altex111/Quadruped/Docs/Presentations/BME-AUT_slide_template_wide_HU (2).pptx

## AUT diasablon

2020.03.21

Notes: Welcome everyone! I’m Gábor Csorvási from the Budapest University of Technology and Economics, and I’m here to talk about a method to solve the Waiter Motion Problem.

## Dia cím

AUT diasablon

- Fő pont
- Második pont

Notes: Nowadays automation and robotics is one of the most promising branch of engineering. But still has it’s problems.
For example motion planning, where our goal is to determine how to move a robot from A to B configurations.
It may seems an easy task but with many actuators and limitations its still a complex task. Especially if the problem is solved as one huge task.
This is why the most popular approach is to divide the problem into smaller problems which can solve easier.
