altex111/Quadruped/Mechanics/Komáromi Sándor/Quadropod/Quadropod STL/Nyomtatási adatok.xlsx

Név | mennyiség | megjegyzés
BaseBottom_v1 | 1
BaseTop_v1 | 1
LegStart_v1 | 2 | Lehet hogy először fejjel lefelé fogja beszúrni. Az egyik oldalon vannak bemélyített csavarhelyek
LegStart_v1_MIR | 2
LegMiddle_Final_1 | 4
LegEnd_Right_v2 | 2
LegEnd_Right_v2_MIR | 2
LegPin_Corner_v1 | 5
LegPin_Side_v1 | 2
LegPin_Side_v1_MIR | 2
LegPin_v1 | 10
