altex111/Quadruped/Docs/Babits Mátyás/docs/images/quad_side másolata.PNG

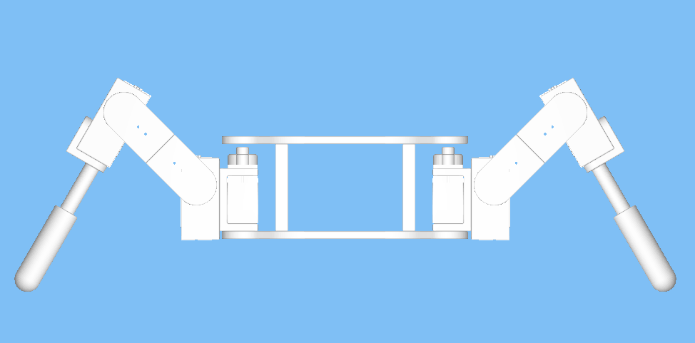
Docs/Babits Mátyás/docs/images/quad_side másolata.PNG
