altex111/Quadruped/Docs/Babits Mátyás/docs/images/quad_top másolata.PNG

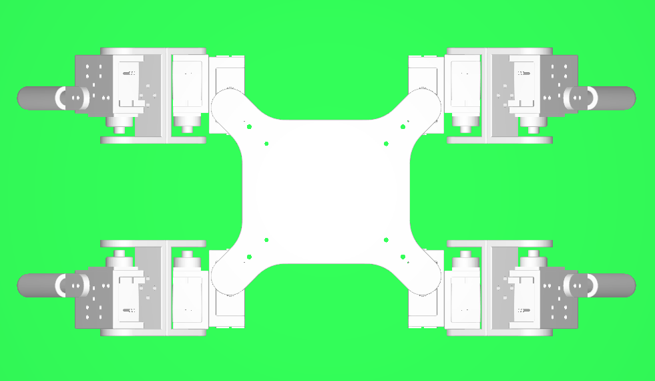
Docs/Babits Mátyás/docs/images/quad_top másolata.PNG
