altex111/Quadruped/Docs/Komaromi Sandor/fotok/Képernyőkép 2021-05-21 165501.png

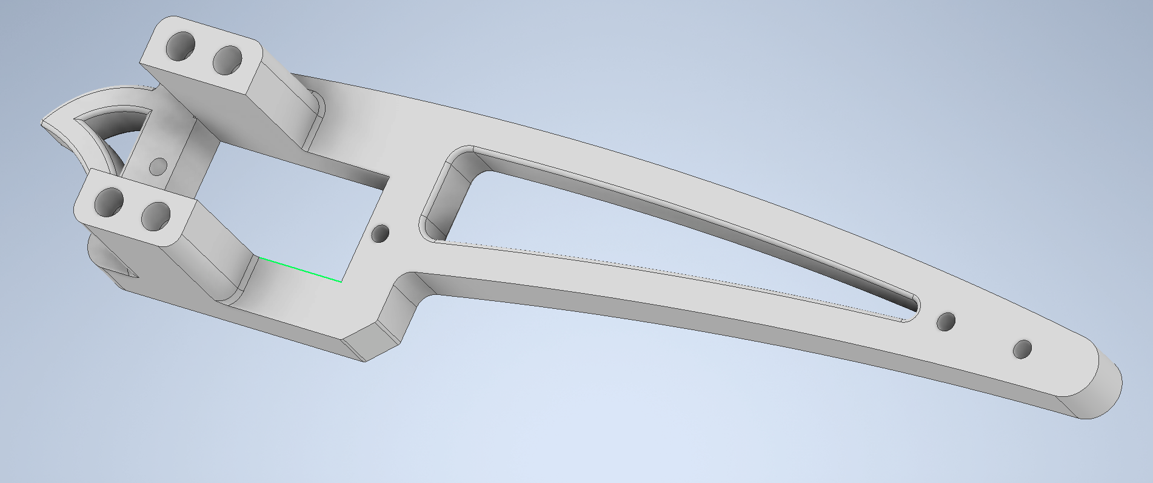
Docs/Komaromi Sandor/fotok/Képernyőkép 2021-05-21 165501.png
