altex111/Quadruped/Docs/Komaromi Sandor/fotok/LIDAR.png

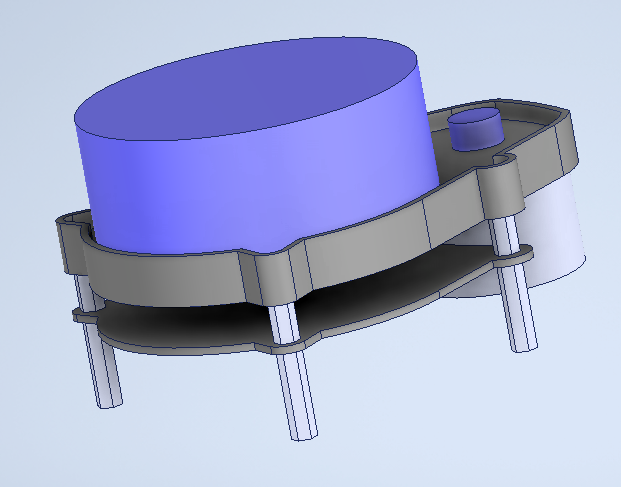
Docs/Komaromi Sandor/fotok/LIDAR.png
