altex111/Quadruped/Docs/Presentations/képek/lab-reszlet-2.png

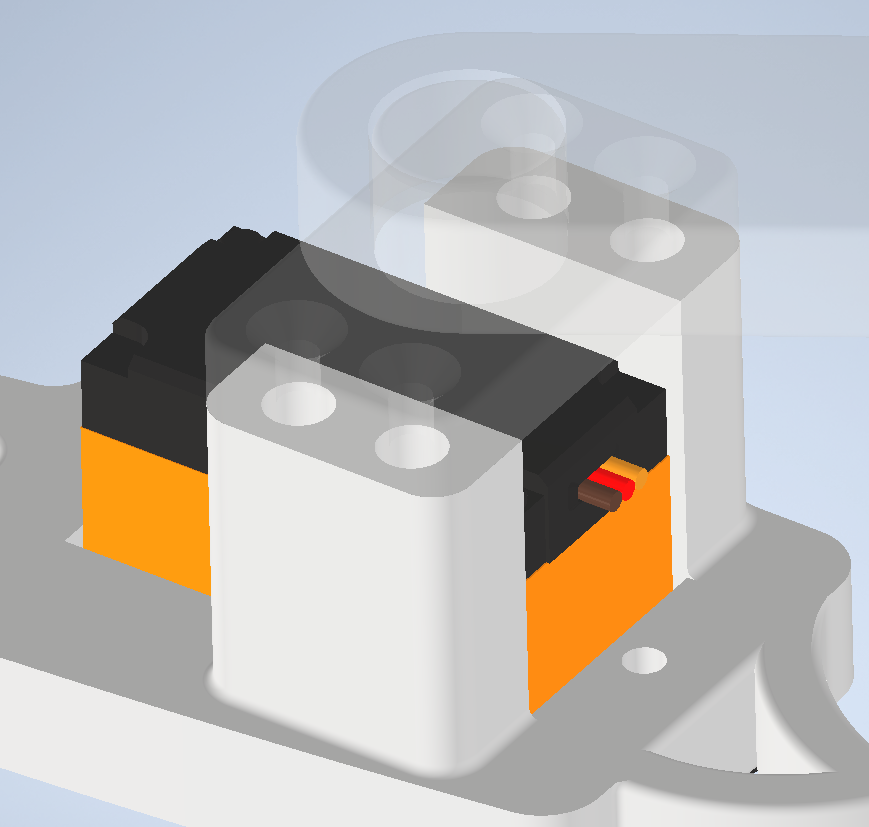
Docs/Presentations/képek/lab-reszlet-2.png
