altex111/Quadruped/Docs/Presentations/képek/mozgas-forgas.jpg

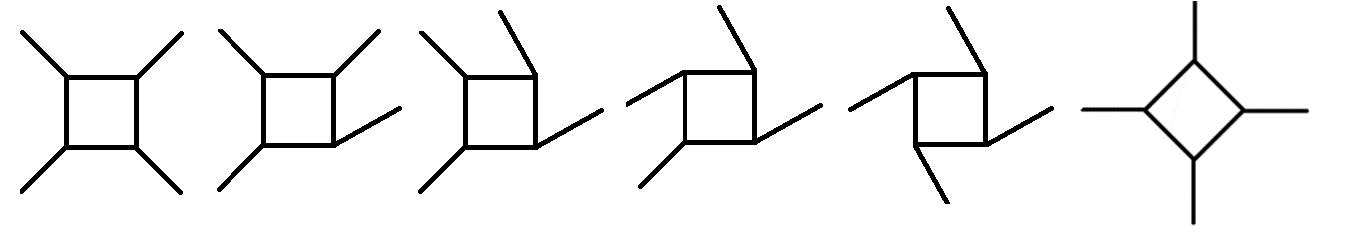
Docs/Presentations/képek/mozgas-forgas.jpg
