altex111/Quadruped/Docs/Presentations/képek/persely-M2.jpg

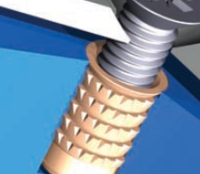
Docs/Presentations/képek/persely-M2.jpg
