altex111/Quadruped/Docs/Presentations/képek/persely-M4.jpg

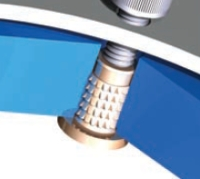
Docs/Presentations/képek/persely-M4.jpg
