altex111/Quadruped/Docs/Presentations/képek/robot-köszön.png

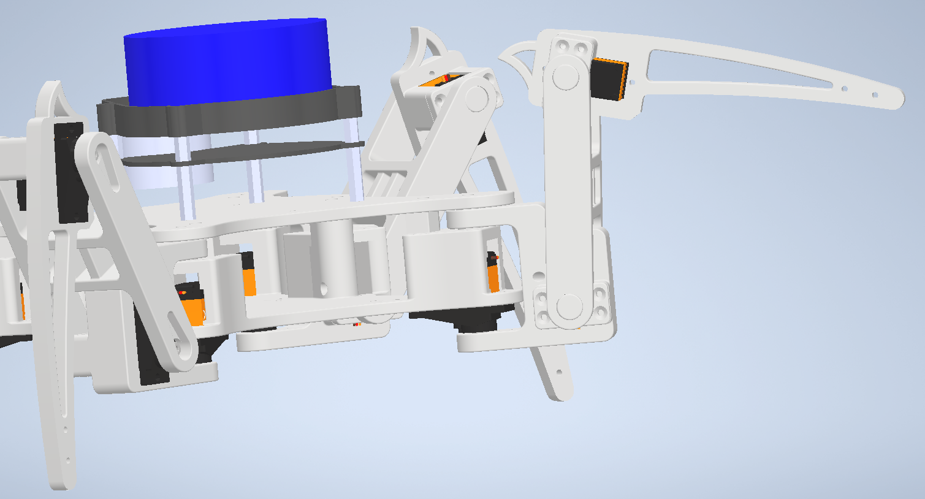
Docs/Presentations/képek/robot-köszön.png
