altex111/Quadruped/Docs/Presentations/képek/szervo-2.jpg

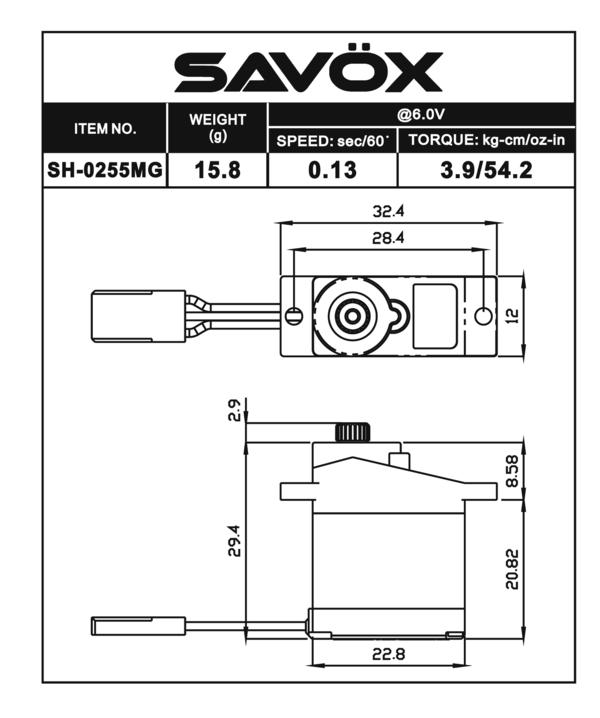
Docs/Presentations/képek/szervo-2.jpg
