altex111/Quadruped/Docs/Presentations/képek/szervo.jpg

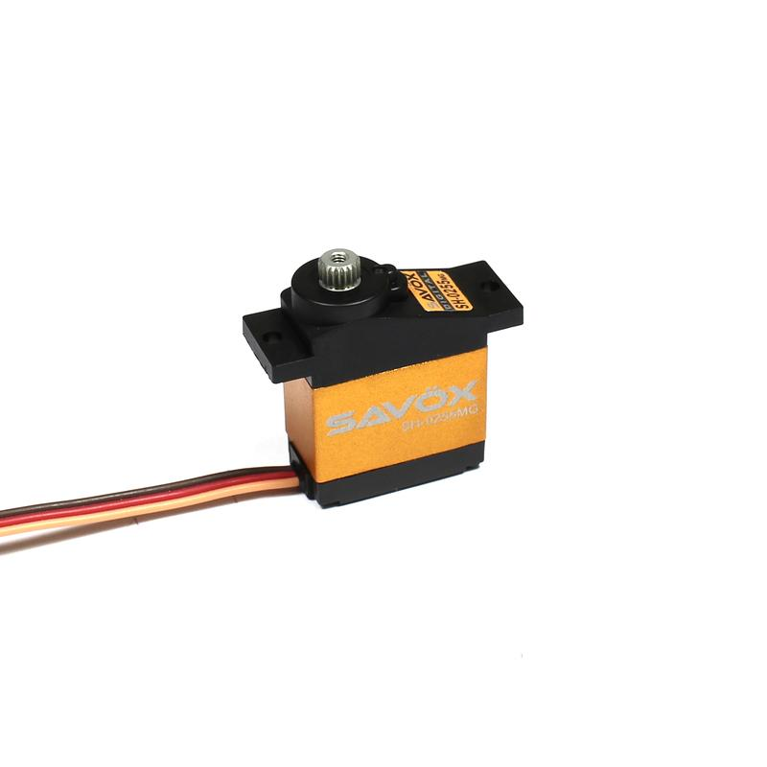
Docs/Presentations/képek/szervo.jpg
