altex111/Quadruped/Docs/Presentations/képek/teszt-pad.png

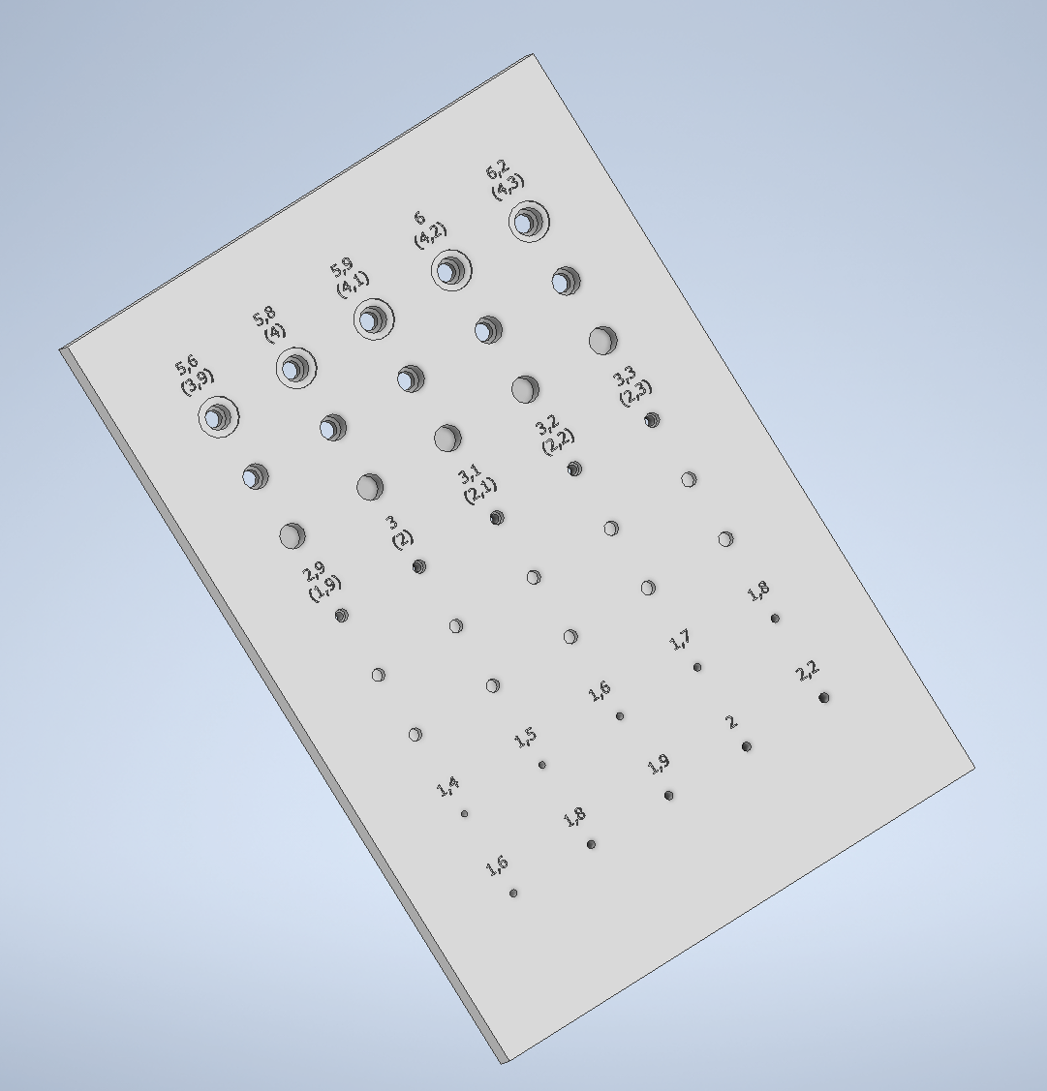
Docs/Presentations/képek/teszt-pad.png
