altex111/Quadruped/Docs/Presentations/képek/zokni.png

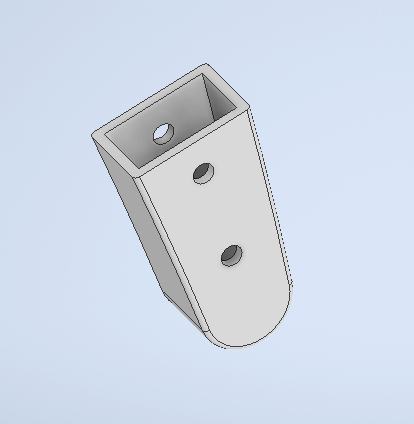
Docs/Presentations/képek/zokni.png
