altex111/Quadruped/Hardware/Massár Lóránt Mátyás/Quadruped_06_18.xlsx

Description | Designator | Reference | Quantity | Supplier | ProjectName | Name
 | S | 1437697 | 1 | Farnell | Quadruped.PrjPcb | Kapcsoló: csúszó; Pozíció:2; SPDT; 2A/250VAC; 5A/28VDC; ON-ON
 | B_RST | 1333652 | 1 | Farnell | Quadruped.PrjPcb | TACT 2.5x 3 2P SPST B3U-1000P (OMR) 2.5x3x1.2mm SMD H=1.2mm 153g
 | U3 | 1593489 | 1 | Farnell |  | Board-To-Board Connector, 2.54 mm, 8 Contacts, Receptacle, 2214S Series, Through Hole, 2 Rows - ESP-01 csatlakozó
 | U1 | 2494459 | 1 | Farnell | Quadruped.PrjPcb | STM32L476RET6 - ARM Microcontroller, Ultra Low Power, STM32 Family STM32L4 Series Microcontrollers, 32bit, 80 MHz
 | U_3V3 | 7208359 | 1 | Farnell | Quadruped.PrjPcb | TS1117BCW-3.3 - Fixed LDO Voltage Regulator, 0V to 12V, 1.3V Dropout, 3.3Vout, 800mAout, SOT-223-3
 | U_5V | 3125120 | 1 | Farnell | Quadruped.PrjPcb | PTH08T231WAD - Non Isolated POL DC/DC Converter, 1 Output, 33 W, 5.5 V, 6 A, Adjustable, Through Hole
Capacitor | C7, C8 | 1762635 | 5 | Farnell | Quadruped.PrjPcb | SMD Multilayer Ceramic Capacitor, 0805
Capacitor | C11 | 2671588 | 2 | Farnell | Quadruped.PrjPcb | GRM32ER60J227ME05L - SMD Multilayer Ceramic Capacitor, 1210 [3225 Metric], 220 µF, 6.3 V, ± 20%, X5R, GRM Series
Polarized Capacitor | C9 | 2762172 | 2 | Farnell | Quadruped.PrjPcb | T491D337M010AT - Surface Mount Tantalum Capacitor, 330 µF, 10 V, T491 Series, ± 20%, 2917 [7343 Metric]
Quarz Crystal | X1 | 2508478 | 1 | Farnell | Quadruped.PrjPcb | QCS8.00000F18B23M - Crystal, 8 MHz, SMD, 12.5mm x 4.6mm, 30 ppm, 18 pF, 20 ppm, QCS Series
Resistor | R1 | 9233938 | 5 | Farnell | Quadruped.PrjPcb | YAGEO (PHYCOMP) RC0805JR-07270RL SMD Chip Resistor, Thick Film, 270 ohm
Resistor | R6 | 2073848 | 5 | Farnell | Quadruped.PrjPcb | MULTICOMP MCMR08X820 JTL SMD Chip Resistor, Ceramic, 82 ohm
Resistor | R9 | 9233881 | 5 | Farnell | Quadruped.PrjPcb | YAGEO (PHYCOMP) RC0805JR-07100RL SMD Chip Resistor, Thick Film, 100 ohm,
Resistor | R10, R11 | 9234004 | 5 | Farnell | Quadruped.PrjPcb | YAGEO (PHYCOMP) RC0805JR-071KL SMD Chip Resistor, Thick Film, 1 kohm
Polarized Capacitor | C10 | 92-01-91 | 5 | Lomex | Quadruped.PrjPcb | 100uF ˝B˝ 10V 20% TAJB107M010RNJ (AVX) 3528
 | P_lb_b, P_lb_k, P_lb_s, P_lf_b, P_lf_k, P_lf_s, P_rb_b, P_rb_k, P_rb_s, P_rf_b, P_rf_k, P_rf_s | 43-16-04 | 12 | Lomex | Quadruped.PrjPcb | TÁPCSATL. 2.00mm 3P APA 180° NCW200-03S (G-S) FORR.
 | P_P | 43-27-99 | 1 | Lomex | Quadruped.PrjPcb | SORKAPOCS 2 P RM3.81 CSAPSORLÉC 90° TLPHC100R-02P (TLM) ZÁRT 10A 150V VDE
4pin Connector | PDB | 43-09-96 | 1 | Lomex | Quadruped.PrjPcb | TÁPCSATL. 2.54mm 4P APA 90° NCW254-04R (G-S) FORR.
Blue LED | D1 | 95-01-58 | 2 | Lomex | Quadruped.PrjPcb | 2012 BLUE 465nm 170mcd FYLS-0805UBC (FYL) W.CLEAR 2.0x1.2x0.8mm 0805 130°
Capacitor | C1, C2 | 82-10-76 | 5 | Lomex | Quadruped.PrjPcb | 100nF 0805 10% 50V X7R 0805B104K500CT (WAL)
Capacitor | C5, C6 | 82-12-79 | 5 | Lomex | Quadruped.PrjPcb | 18pF 0805 5% 50V NP0 CL21C180JBANNNC (SAM)
Fuse | F1 | 44-03-11 | 5 | Lomex | Quadruped.PrjPcb | Lomex
Red LED | D2 | 95-00-19 | 2 | Lomex | Quadruped.PrjPcb | 2012 RED 643nm 28mcd FYLS-0805HRC (FYL) W.CLEAR 2.0x1.2x0.8mm 0805 130°
Resistor | R2, R3, R4 | 80-11-47 | 5 | Lomex | Quadruped.PrjPcb | 20K0 0805 1% CR-05FL7---20K 0.125W (VIK)
Resistor | R5 | 81-34-68 | 5 | Lomex | Quadruped.PrjPcb | 0R00 0805 CR-05JL7----0R 0.125W (VIK) Iav=2A
Resistor | R13 | 80-01-97 | 5 | Lomex | Quadruped.PrjPcb | 160R 0805 1% RC0805FR-07160RL 0.125W (YAG)
Yellow LED | D5 | 95-03-84 | 2 | Lomex | Quadruped.PrjPcb | 2012 YELLOW 590nm 220mcd 0805UYC (FEM) 20mA W.CLEAR 2.0x1.2x0.68mm 0805 140°
 | 4pin Connector for BNO055 | 43-30-32 | 1 | Lomex |  | HÜVELY 4 P FHSH-2.54-04 (T-T) 1# h=8,5mm AU
 | 6pin Connector for BNO055 | 43-28-13 | 1 | Lomex |  | HÜVELY 6 P FHSH-2.54-06 (T-T) 1# h=8,5mm AU
 | PDB | 43-09-08 | 1 | Lomex |  | TÁPCSATL. 2.54mm 4P ANYA HÁZ NCH254-04 (G-S)
 | 2.54mm crimp | 43-26-57 | 50 | Lomex |  | TÁPCSATL. 2.54mm ANYA CRIMP. DNCT254-T22F (G-S) AWG22-28 TIN ÓNOZOTT
 | P_lb | 43-15-99 | 3 | Lomex |  | TÁPCSATL. 2.00mm 3P ANYA HÁZ NCH200-03 (G-S)
 | YDLIDAR X2 csatlakozó | 43-15-91 | 0 | Lomex |  | TÁPCSATL. 1.25mm 4P APA 180° MNCW125-04S (G-S) FORR.
 | YDLIDAR X2 csatlakozó (1.25mm) crimp | 43-15-97 | 0 | Lomex |  | TÁPCSATL. 1.25mm ANYA CRIMP. AWG28-32 MNCT125-T28 (G-S) ÓNOZOTT
 | 2.00 mm crimp | 43-00-25 | 20 | Lomex |  | TÁPCSATL. 2.00mm ANYA CRIMP. NCT200S-T2430 (G-S) AWG24-30
4pin Connector | PLIDAR | 43-17-55 | 1 | Lomex | Quadruped.PrjPcb | TÁPCSATL. 2.00mm 4P APA 90° B4B-PH-SM4-TB (LF)(SN) (JST) SMD Ł
 | Adafruit BNO055 | 485-2472 | 1 | Mouser Electronics | Quadruped.PrjPcb | Adafruit BNO055
 | YDLIDAR X2 | RB-Ydl-04 | 1 | Robotshop |  | YDLIDAR X2 360° Laser Scanner
