altex111/Quadruped/Mechanics/Babits Mátyás/servo.stl

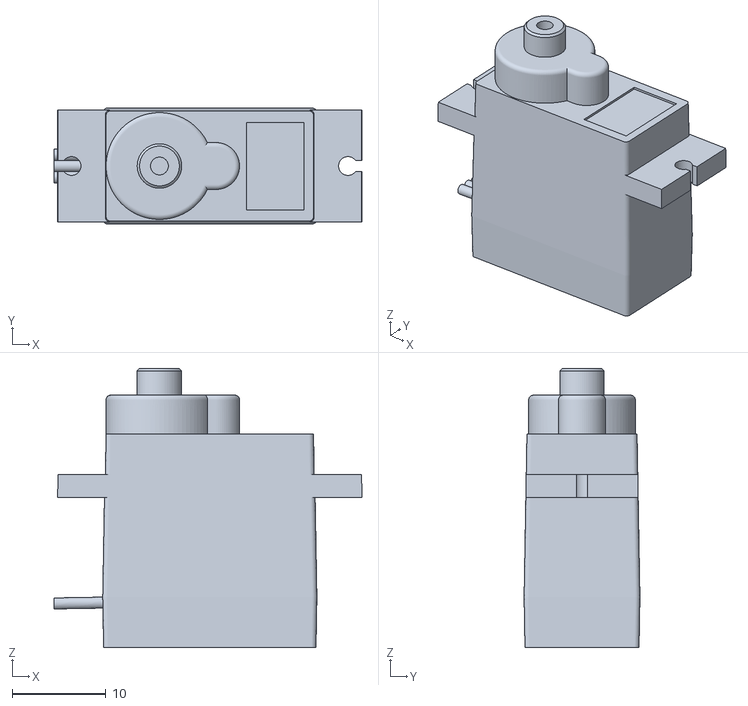
[picture p92: CAD file, 2022-03-31]
Mechanics/Babits Mátyás/servo.stl
32.9 x 12.4 x 29.8
