altex111/Quadruped/Mechanics/Komáromi Sándor/Quadropod/Quadropod MDL/SimulationModell_STL/LegEnd.stl

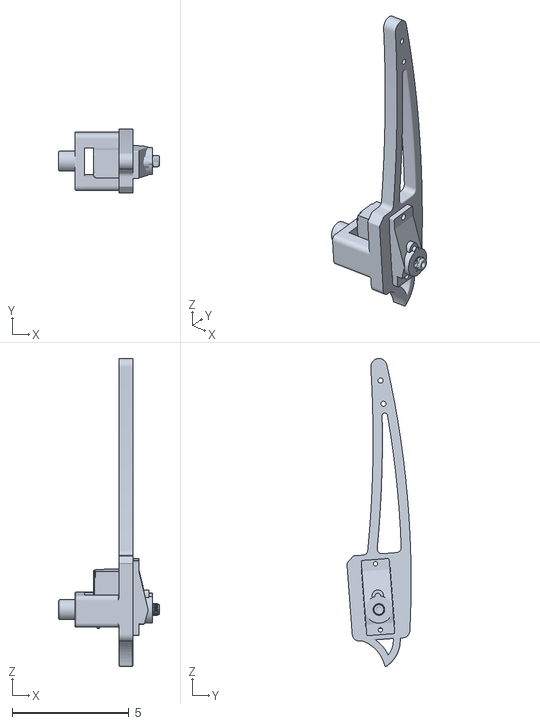
[picture p93: CAD file, 2022-04-13]
Mechanics/Komáromi Sándor/Quadropod/Quadropod MDL/SimulationModell_STL/LegEnd.stl
4.32 x 2.75 x 13.2
