altex111/Quadruped/Mechanics/Komáromi Sándor/Quadropod/Quadropod STL/BaseTop_v1.stl

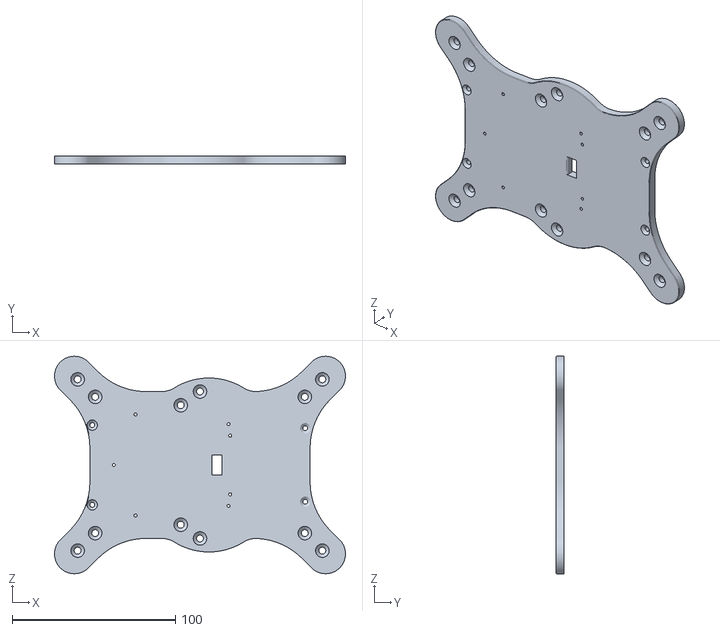
[picture p94: CAD file, 2022-03-31]
Mechanics/Komáromi Sándor/Quadropod/Quadropod STL/BaseTop_v1.stl
178.3 x 5.00 x 133.3
