altex111/Quadruped/Quadruped/Mechanics/Komáromi Sándor/Quadropod/Quadropod MDL/SimulationModell_STL/LegMiddle.stl

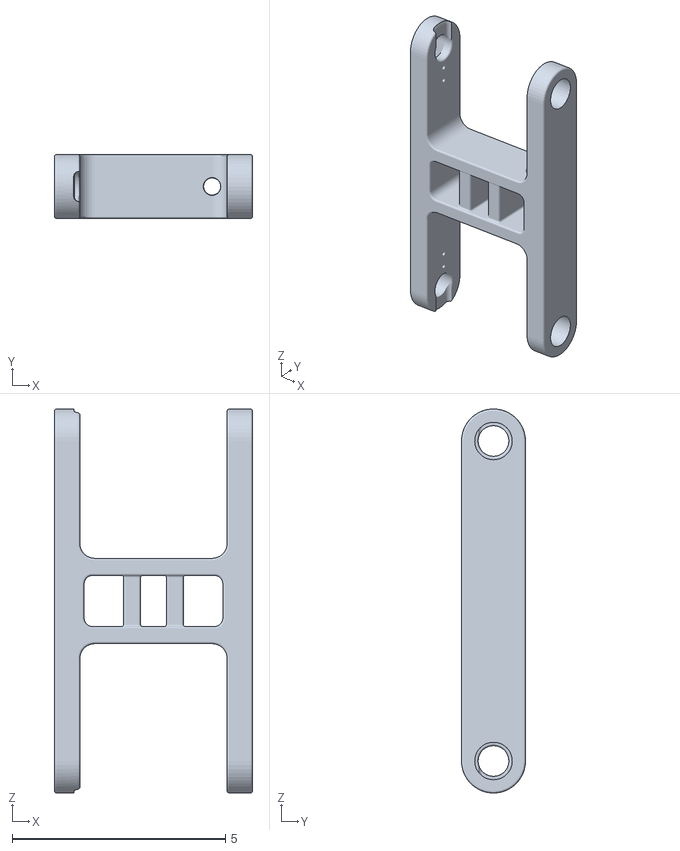
[picture p95: CAD file, 2022-04-03]
Quadruped/Mechanics/Komáromi Sándor/Quadropod/Quadropod MDL/SimulationModell_STL/LegMiddle.stl
4.65 x 1.50 x 9.00
