altex111/Quadruped/Quadruped/Mechanics/Komáromi Sándor/Quadropod/Quadropod STL/LegMiddle_Final_1.stl

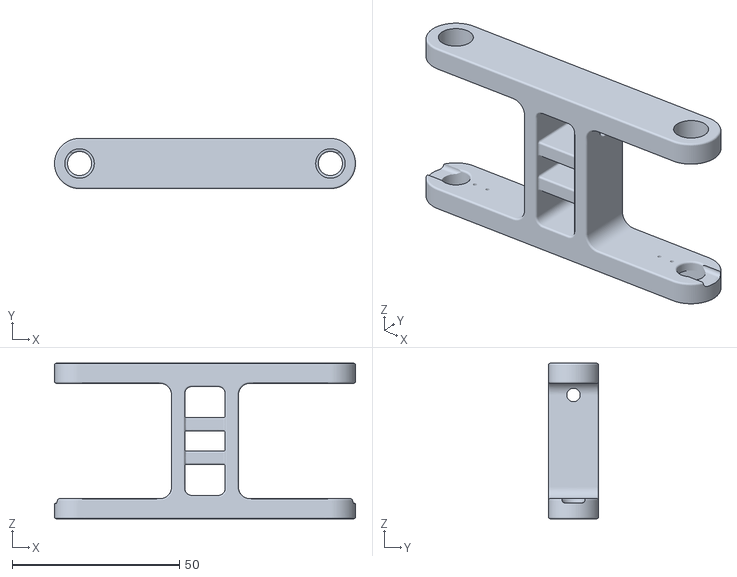
[picture p96: CAD file, 2022-03-31]
Quadruped/Mechanics/Komáromi Sándor/Quadropod/Quadropod STL/LegMiddle_Final_1.stl
90.0 x 15.0 x 46.5
