altex111/Quadruped/Mechanics/Babits Mátyás/support.stl

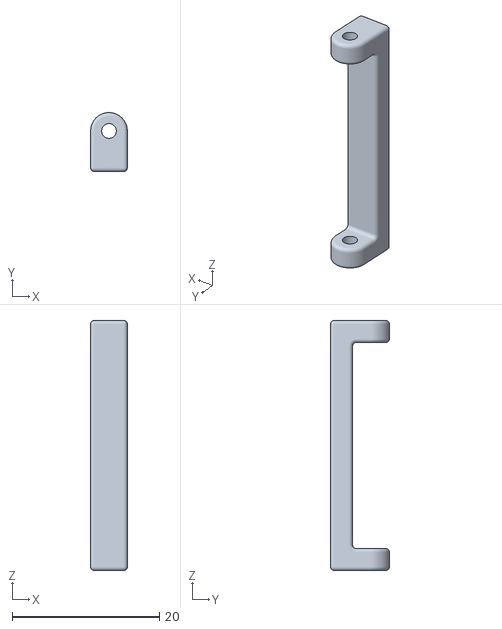
[picture p97: CAD file, 2022-03-31]
Mechanics/Babits Mátyás/support.stl
5.00 x 8.00 x 34.0
