altex111/Quadruped/Mechanics/Komáromi Sándor/Quadropod/Quadropod STL/LegPin_Side_v1.stl

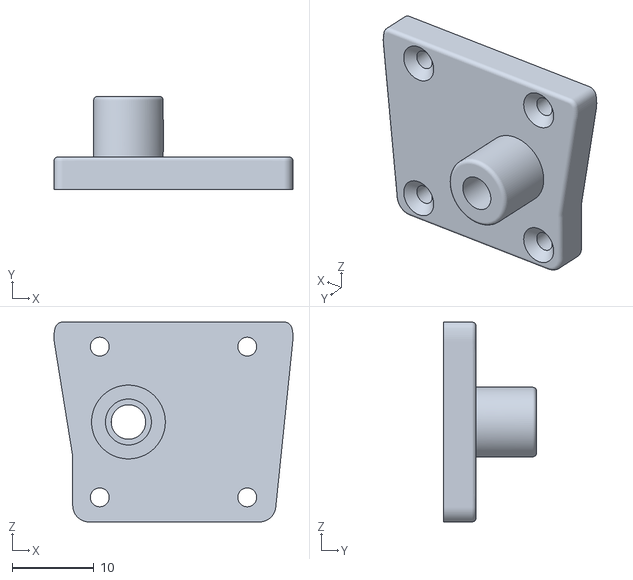
[picture p98: CAD file, 2022-03-31]
Mechanics/Komáromi Sándor/Quadropod/Quadropod STL/LegPin_Side_v1.stl
29.2 x 11.4 x 24.4
