altex111/Quadruped/Quadruped/Mechanics/Komáromi Sándor/Quadropod/Quadropod STL/LegStart_v1.stl

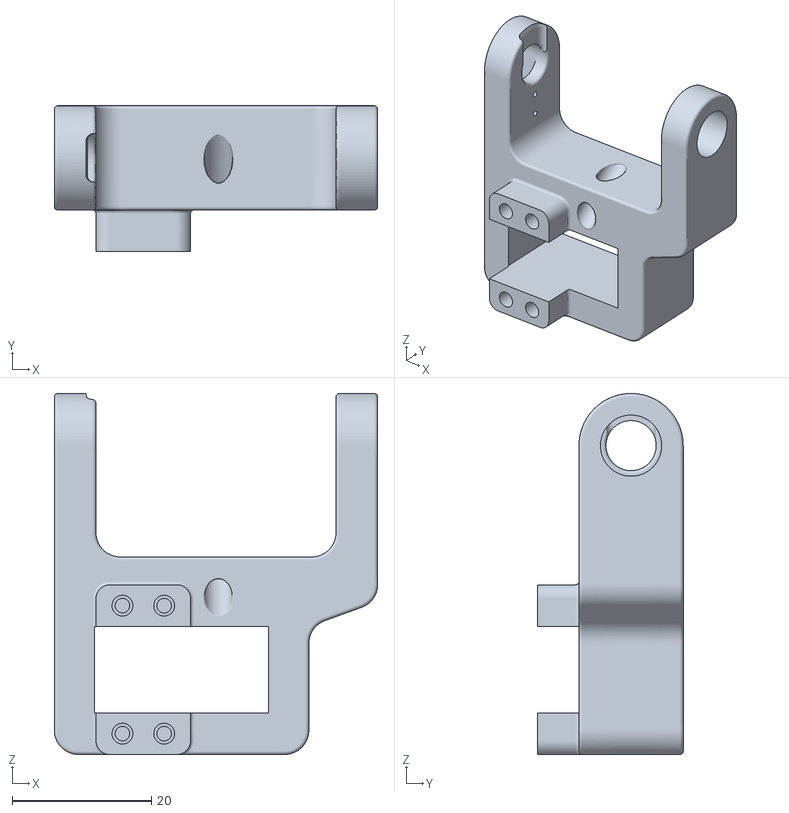
[picture p99: CAD file, 2022-03-31]
Quadruped/Mechanics/Komáromi Sándor/Quadropod/Quadropod STL/LegStart_v1.stl
46.5 x 20.9 x 51.9
