altex111/Quadruped/Mechanics/Babits Mátyás/end.stl

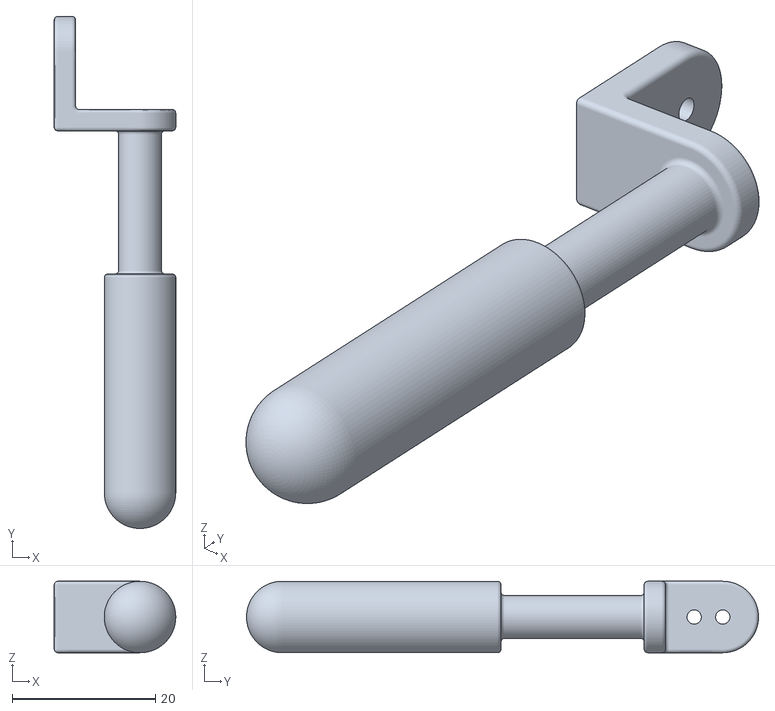
[picture p100: CAD file, 2022-03-31]
Mechanics/Babits Mátyás/end.stl
17.0 x 71.6 x 10.0
