altex111/Quadruped/Mechanics/Komáromi Sándor/Quadropod/Quadropod MDL/SimulationModell_STL/LegStart_MIR.stl

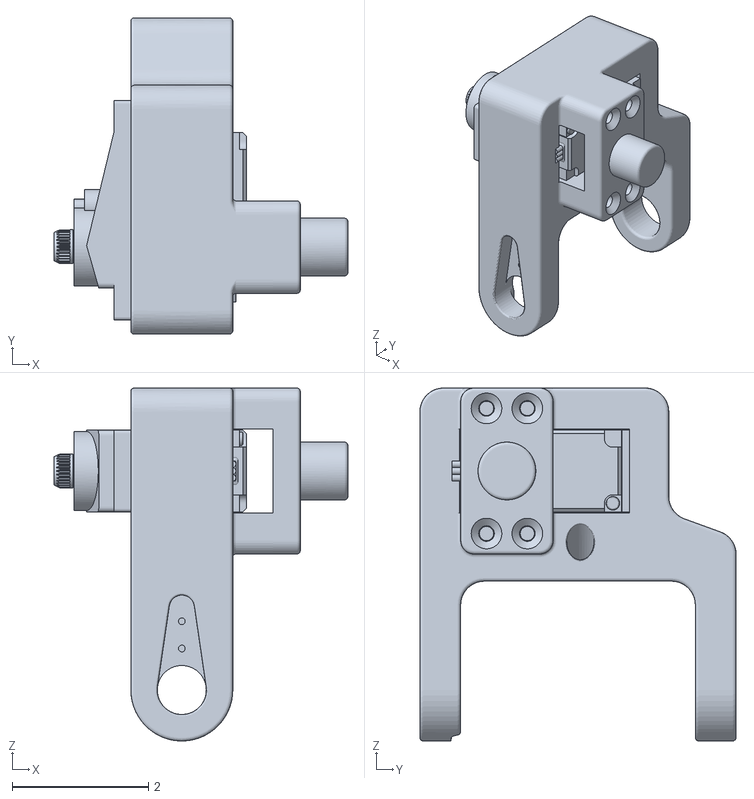
[picture p101: CAD file, 2022-04-13]
Mechanics/Komáromi Sándor/Quadropod/Quadropod MDL/SimulationModell_STL/LegStart_MIR.stl
4.32 x 4.65 x 5.19
