altex111/Quadruped/Mechanics/Babits Mátyás/holder.stl

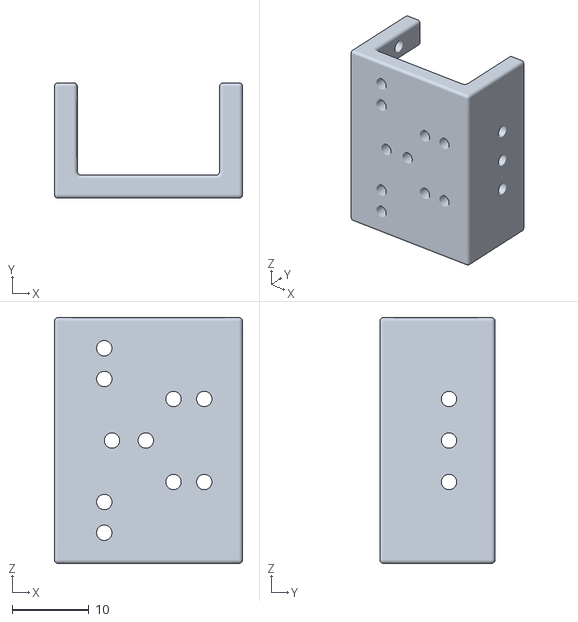
[picture p102: CAD file, 2022-03-31]
Mechanics/Babits Mátyás/holder.stl
24.5 x 15.0 x 32.0
