altex111/Quadruped/Quadruped/Mechanics/Babits Mátyás/body.stl

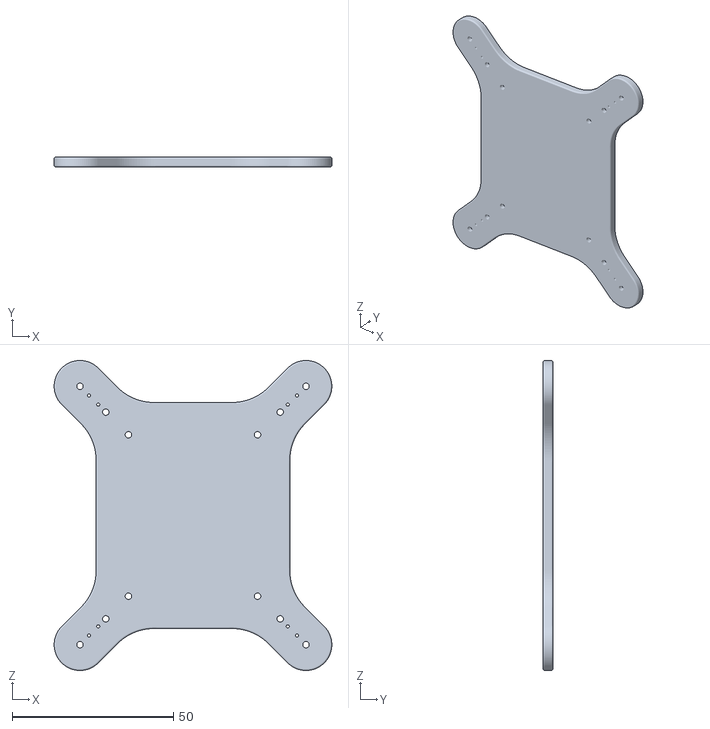
[picture p103: CAD file, 2022-03-31]
Quadruped/Mechanics/Babits Mátyás/body.stl
86.0 x 3.00 x 96.0
