altex111/Quadruped/Mechanics/Komáromi Sándor/Quadropod/Quadropod STL/LegEnd_Right_v2_MIR.stl

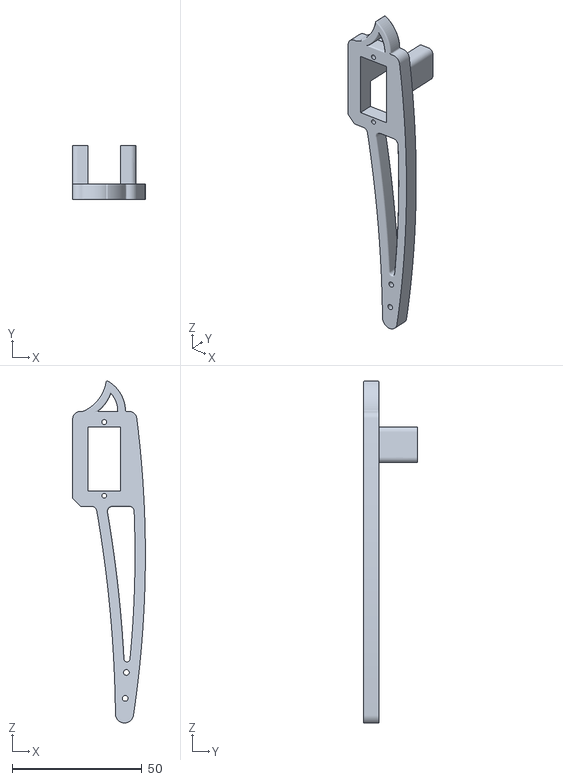
[picture p104: CAD file, 2022-03-31]
Mechanics/Komáromi Sándor/Quadropod/Quadropod STL/LegEnd_Right_v2_MIR.stl
28.0 x 20.9 x 131.8
