altex111/Quadruped/Mechanics/Babits Mátyás/thigh.stl

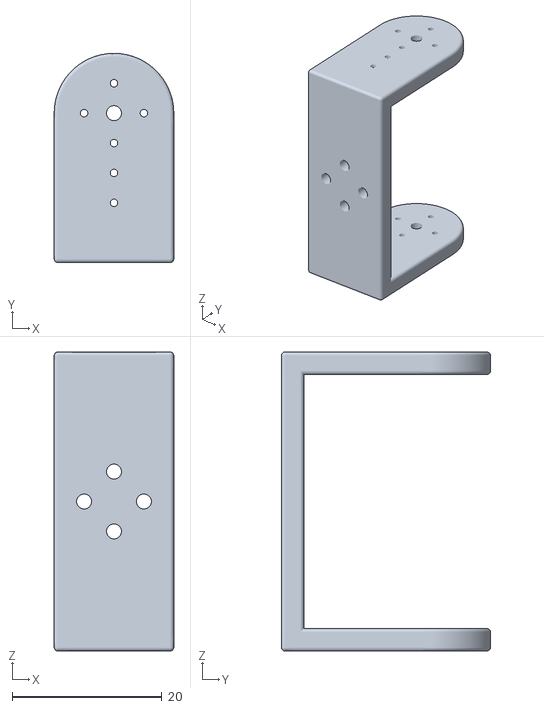
[picture p105: CAD file, 2022-03-31]
Mechanics/Babits Mátyás/thigh.stl
16.0 x 28.0 x 40.0
