altex111/Quadruped/Mechanics/Komáromi Sándor/Quadropod/Quadropod MDL/SimulationModell_STL/Body.stl

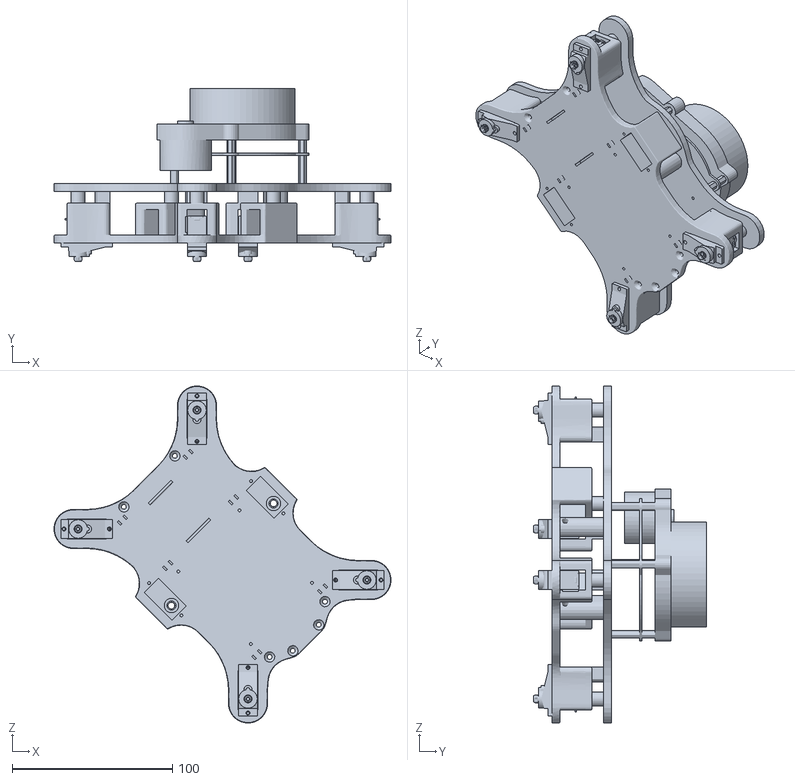
[picture p106: CAD file, 2022-03-31]
Mechanics/Komáromi Sándor/Quadropod/Quadropod MDL/SimulationModell_STL/Body.stl
210.2 x 107.6 x 210.2
