altex111/Quadruped/Mechanics/Komáromi Sándor/Quadropod/Quadropod STL/LegPin_Middle_v1.stl

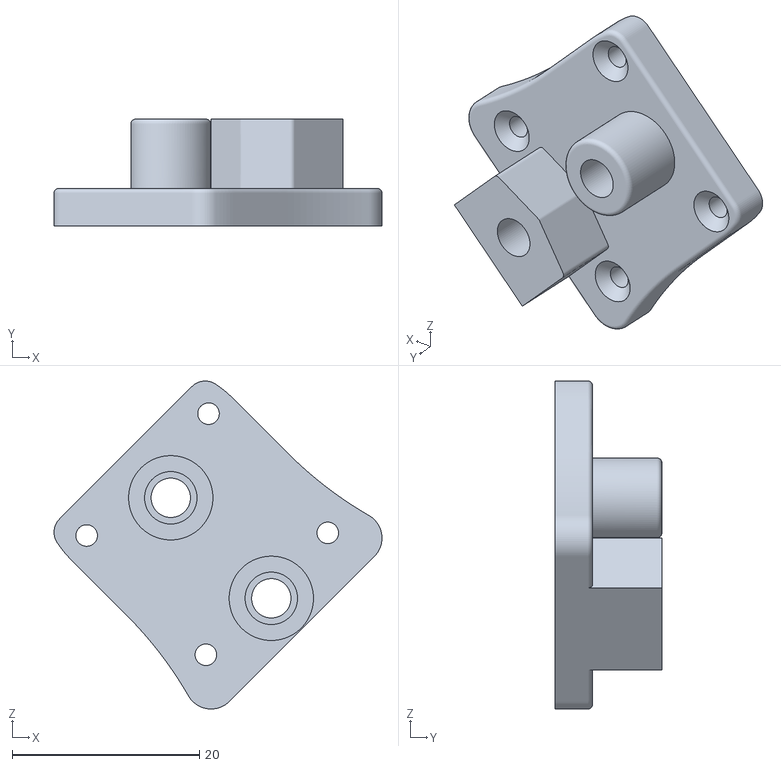
[picture p107: CAD file, 2022-03-31]
Mechanics/Komáromi Sándor/Quadropod/Quadropod STL/LegPin_Middle_v1.stl
35.0 x 11.4 x 35.0
