altex111/Quadruped/Mechanics/Komáromi Sándor/Quadropod/Quadropod STL/LegPin_v1.stl

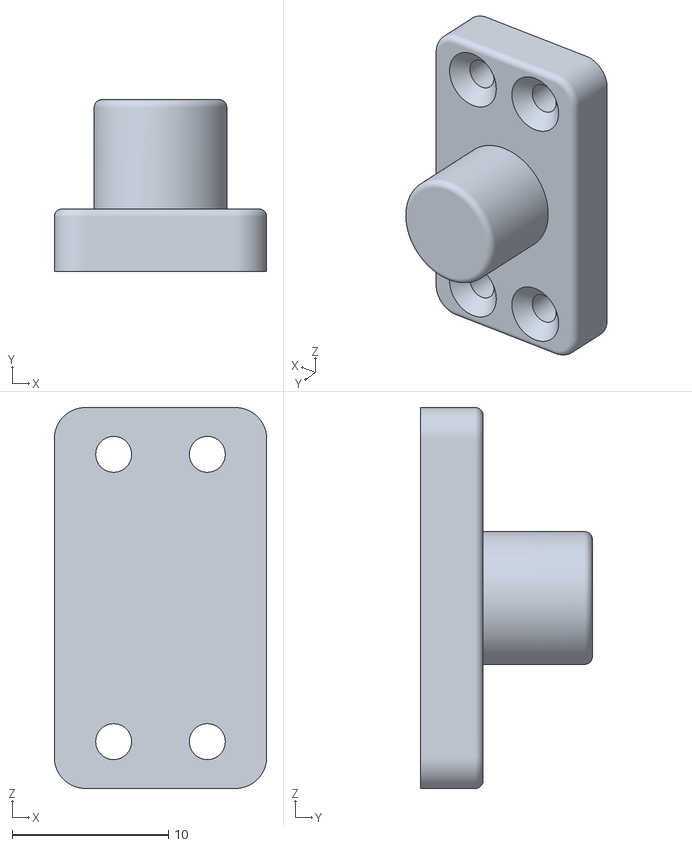
[picture p108: CAD file, 2022-03-31]
Mechanics/Komáromi Sándor/Quadropod/Quadropod STL/LegPin_v1.stl
13.6 x 11.0 x 24.4
