altex111/Quadruped/Quadruped/Mechanics/Komáromi Sándor/Quadropod/Quadropod STL/BaseBottom_v1.stl

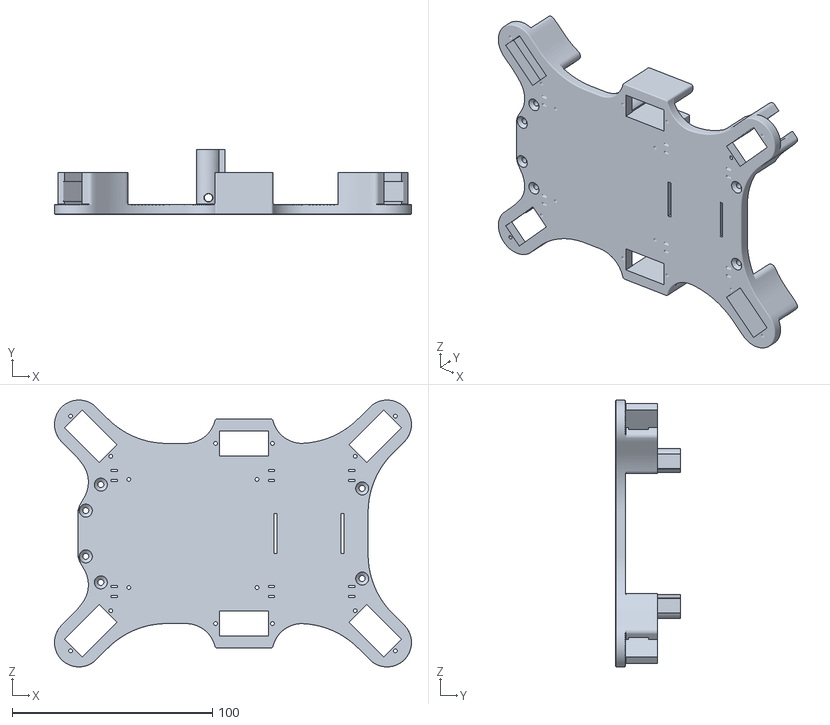
[picture p109: CAD file, 2022-03-31]
Quadruped/Mechanics/Komáromi Sándor/Quadropod/Quadropod STL/BaseBottom_v1.stl
178.3 x 32.3 x 133.3
