altex111/Quadruped/(list of files, cad)

Other CAD files:
Quadruped/Software/Simulator/Debug/x64/Bin/Int/main.obj
Software/Simulator/Debug/x64/Bin/Int/main.obj
Software/Simulator/Debug/x64/Bin/Int/quad_movement.obj
Mechanics/Komáromi Sándor/Quadropod/Quadropod MDL/SimulationModell_STL/LegEnd_MIR.stl
Quadruped/Mechanics/Komáromi Sándor/Quadropod/Quadropod MDL/SimulationModell_STL/LegMiddle_MIR.stl
Quadruped/Software/Simulator/Debug/x64/Bin/Int/position.obj
Software/Simulator/Debug/x64/Bin/Int/quad_quad.obj
Mechanics/Komáromi Sándor/Quadropod/Quadropod STL/LegStart_v1_MIR1.stl
Quadruped/Mechanics/Komáromi Sándor/Quadropod/Quadropod MDL/SimulationModell_STL/LegEnd.stl
Quadruped/Software/Simulator/Debug/x64/Bin/Int/renderer.obj
Software/Simulator/Debug/x64/Bin/Int/graphics.obj
Mechanics/Komáromi Sándor/Quadropod/Quadropod MDL/SimulationModell_STL/LegMiddle_MIR.stl
Mechanics/Komáromi Sándor/Quadropod/Quadropod STL/LegPin_Side_v1_MIR.stl
Quadruped/Mechanics/Komáromi Sándor/Quadropod/Quadropod MDL/SimulationModell_STL/LegStart_MIR.stl
Quadruped/Mechanics/Komáromi Sándor/Quadropod/Quadropod STL/LegPin_Side_v1_MIR.stl
Quadruped/Software/Simulator/Debug/x64/Bin/Int/quad_quad.obj
Software/Simulator/Debug/x64/Bin/Int/position.obj
Mechanics/Komáromi Sándor/Quadropod/Quadropod MDL/SimulationModell_STL/LegMiddle.stl
Quadruped/Mechanics/Komáromi Sándor/Quadropod/Quadropod MDL/SimulationModell_STL/LegStart.stl
Quadruped/Software/Simulator/Debug/x64/Bin/Int/quad_walkscript.obj
Software/Simulator/Debug/x64/Bin/Int/linalg.obj
Mechanics/Komáromi Sándor/Quadropod/Quadropod MDL/SimulationModell_STL/LegStart.stl
Quadruped/Mechanics/Komáromi Sándor/Quadropod/Quadropod MDL/SimulationModell_STL/LegEnd_MIR.stl
Quadruped/Mechanics/Komáromi Sándor/Quadropod/Quadropod STL/LegStart_v1_MIR1.stl
Quadruped/Software/Simulator/Debug/x64/Bin/Int/quad_scene.obj
Quadruped/Mechanics/Komáromi Sándor/Quadropod/Quadropod STL/LegEnd_Right_v2.stl
Quadruped/Software/Simulator/Debug/x64/Bin/Int/camera.obj
Software/Simulator/Debug/x64/Bin/Int/quad_scene.obj
Quadruped/Software/Simulator/Debug/x64/Bin/Int/model.obj
Software/Simulator/Debug/x64/Bin/Int/quad_walkscript.obj
Quadruped/Software/Simulator/Debug/x64/Bin/Int/quad_movement.obj
Software/Simulator/Debug/x64/Bin/Int/renderer.obj
Mechanics/Komáromi Sándor/Quadropod/Quadropod STL/LegEnd_Right_v2.stl
Quadruped/Software/Simulator/Debug/x64/Bin/Int/entity.obj
Software/Simulator/Debug/x64/Bin/Int/camera.obj
Quadruped/Software/Simulator/Debug/x64/Bin/Int/graphics.obj
Software/Simulator/Debug/x64/Bin/Int/model.obj
Quadruped/Software/Simulator/Debug/x64/Bin/Int/window.obj
Software/Simulator/Debug/x64/Bin/Int/entity.obj
Quadruped/Software/Simulator/Debug/x64/Bin/Int/linalg.obj
Software/Simulator/Debug/x64/Bin/Int/window.obj
Mechanics/Babits Mátyás/body.ipt
Mechanics/Babits Mátyás/fork.ipt
Mechanics/Babits Mátyás/holder.ipt
Mechanics/Babits Mátyás/support.ipt
Mechanics/Babits Mátyás/toe.ipt
Mechanics/Babits Mátyás/towerpro sg90.ipt
Mechanics/Komáromi Sándor/Quadropod/BaseBottom_v1.ipt
Mechanics/Komáromi Sándor/Quadropod/BaseTop_v1.ipt
Mechanics/Komáromi Sándor/Quadropod/LegEnd_1.ipt
Mechanics/Komáromi Sándor/Quadropod/LegEnd_Base.ipt
Mechanics/Komáromi Sándor/Quadropod/LegEnd_Left_v1.ipt
Mechanics/Komáromi Sándor/Quadropod/LegEnd_Right_Head.ipt
Mechanics/Komáromi Sándor/Quadropod/LegEnd_Right_v1.ipt
Mechanics/Komáromi Sándor/Quadropod/LegEnd_Right_v1_MIR.ipt
Mechanics/Komáromi Sándor/Quadropod/LegEnd_Right_v2.ipt
Mechanics/Komáromi Sándor/Quadropod/LegEnd_Right_v2_MIR.ipt
Mechanics/Komáromi Sándor/Quadropod/LegMiddle.ipt
Mechanics/Komáromi Sándor/Quadropod/LegMiddle_Final_1.ipt
Mechanics/Komáromi Sándor/Quadropod/LegMiddle_Final_1_MIR.ipt
Mechanics/Komáromi Sándor/Quadropod/LegMiddle_Final_2.ipt
Mechanics/Komáromi Sándor/Quadropod/LegPin_Middle_v1.ipt
Mechanics/Komáromi Sándor/Quadropod/LegPin_Side_fillet_v1.ipt
Mechanics/Komáromi Sándor/Quadropod/LegPin_Side_v1.ipt
Mechanics/Komáromi Sándor/Quadropod/LegPin_Side_v1_MIR.ipt
Mechanics/Komáromi Sándor/Quadropod/LegPin_v1.ipt
Mechanics/Komáromi Sándor/Quadropod/LegPin_v1_MIR.ipt
Mechanics/Komáromi Sándor/Quadropod/LegStart_v1.ipt
Mechanics/Komáromi Sándor/Quadropod/LegStart_v1_MIR.ipt
Mechanics/Komáromi Sándor/Quadropod/LegStart_v1_MIR1.ipt
Mechanics/Komáromi Sándor/Quadropod/Leg_Right_v1.iam
Mechanics/Komáromi Sándor/Quadropod/Leg_Right_v1_MIR.iam
Mechanics/Komáromi Sándor/Quadropod/OldVersions/BaseBottom_v1.0039.ipt
Mechanics/Komáromi Sándor/Quadropod/OldVersions/BaseBottom_v1.0040.ipt
Mechanics/Komáromi Sándor/Quadropod/OldVersions/BaseTop_v1.0024.ipt
Mechanics/Komáromi Sándor/Quadropod/OldVersions/LegEnd_1.0003.ipt
Mechanics/Komáromi Sándor/Quadropod/OldVersions/LegEnd_Base.0001.ipt
Mechanics/Komáromi Sándor/Quadropod/OldVersions/LegEnd_Left_v1.0003.ipt
Mechanics/Komáromi Sándor/Quadropod/OldVersions/LegEnd_Left_v1.0004.ipt
Mechanics/Komáromi Sándor/Quadropod/OldVersions/LegEnd_Right_Head.0002.ipt
Mechanics/Komáromi Sándor/Quadropod/OldVersions/LegEnd_Right_v1.0012.ipt
Mechanics/Komáromi Sándor/Quadropod/OldVersions/LegEnd_Right_v1.0013.ipt
Mechanics/Komáromi Sándor/Quadropod/OldVersions/LegEnd_Right_v1.0014.ipt
Mechanics/Komáromi Sándor/Quadropod/OldVersions/LegEnd_Right_v1_MIR.0001.ipt
Mechanics/Komáromi Sándor/Quadropod/OldVersions/LegEnd_Right_v2.0008.ipt
Mechanics/Komáromi Sándor/Quadropod/OldVersions/LegEnd_Right_v2.0009.ipt
Mechanics/Komáromi Sándor/Quadropod/OldVersions/LegEnd_Right_v2.0010.ipt
Mechanics/Komáromi Sándor/Quadropod/OldVersions/LegEnd_Right_v2_MIR.0001.ipt
Mechanics/Komáromi Sándor/Quadropod/OldVersions/LegEnd_Right_v2_MIR.0004.ipt
Mechanics/Komáromi Sándor/Quadropod/OldVersions/LegEnd_Right_v2_MIR.0005.ipt
Mechanics/Komáromi Sándor/Quadropod/OldVersions/LegEnd_v1.0002.ipt
Mechanics/Komáromi Sándor/Quadropod/OldVersions/LegMiddle.0001.ipt
Mechanics/Komáromi Sándor/Quadropod/OldVersions/LegMiddle_Final_1.0022.ipt
Mechanics/Komáromi Sándor/Quadropod/OldVersions/LegMiddle_Final_1_MIR.0001.ipt
Mechanics/Komáromi Sándor/Quadropod/OldVersions/LegMiddle_Final_1_MIR.0002.ipt
Mechanics/Komáromi Sándor/Quadropod/OldVersions/LegPin_Middle_v1.0017.ipt
Mechanics/Komáromi Sándor/Quadropod/OldVersions/LegPin_Side_v1.0017.ipt
Mechanics/Komáromi Sándor/Quadropod/OldVersions/LegPin_Side_v1_MIR.0007.ipt
Mechanics/Komáromi Sándor/Quadropod/OldVersions/LegPin_Side_v1_MIR.0008.ipt
Mechanics/Komáromi Sándor/Quadropod/OldVersions/LegPin_v1.0015.ipt
Mechanics/Komáromi Sándor/Quadropod/OldVersions/LegPin_v1.0018.ipt
Mechanics/Komáromi Sándor/Quadropod/OldVersions/LegPin_v1_MIR.0001.ipt
Mechanics/Komáromi Sándor/Quadropod/OldVersions/LegStart_v1.0025.ipt
Mechanics/Komáromi Sándor/Quadropod/OldVersions/LegStart_v1.0027.ipt
Mechanics/Komáromi Sándor/Quadropod/OldVersions/LegStart_v1.0028.ipt
Mechanics/Komáromi Sándor/Quadropod/OldVersions/LegStart_v1.0029.ipt
Mechanics/Komáromi Sándor/Quadropod/OldVersions/LegStart_v1_MIR.0002.ipt
Mechanics/Komáromi Sándor/Quadropod/OldVersions/LegStart_v1_MIR.0004.ipt
Mechanics/Komáromi Sándor/Quadropod/OldVersions/LegStart_v1_MIR.0005.ipt
Mechanics/Komáromi Sándor/Quadropod/OldVersions/LegStart_v1_MIR1.0001.ipt
Mechanics/Komáromi Sándor/Quadropod/OldVersions/LegStart_v1_MIR1.0002.ipt
Mechanics/Komáromi Sándor/Quadropod/OldVersions/Leg_Right_v1.0010.iam
Mechanics/Komáromi Sándor/Quadropod/OldVersions/Leg_Right_v1.0011.iam
Mechanics/Komáromi Sándor/Quadropod/OldVersions/Leg_Right_v1_MIR.0002.iam
Mechanics/Komáromi Sándor/Quadropod/OldVersions/Leg_Right_v1_MIR.0003.iam
Mechanics/Komáromi Sándor/Quadropod/OldVersions/Quadropod_assemblie.0006.iam
Mechanics/Komáromi Sándor/Quadropod/OldVersions/Quadropod_assemblie.0007.iam
Mechanics/Komáromi Sándor/Quadropod/OldVersions/Quadropod_assembly_v2.0015.iam
Mechanics/Komáromi Sándor/Quadropod/OldVersions/Quadropod_assembly_v2.0016.iam
Mechanics/Komáromi Sándor/Quadropod/OldVersions/Quadropod_assembly_v3.0022.iam
Mechanics/Komáromi Sándor/Quadropod/OldVersions/Quadropod_assembly_v3.0023.iam
Mechanics/Komáromi Sándor/Quadropod/OldVersions/Quadropod_assembly_v3.0024.iam
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
