altex111/Quadruped/Docs/Presentations/képek/test-kabel.png

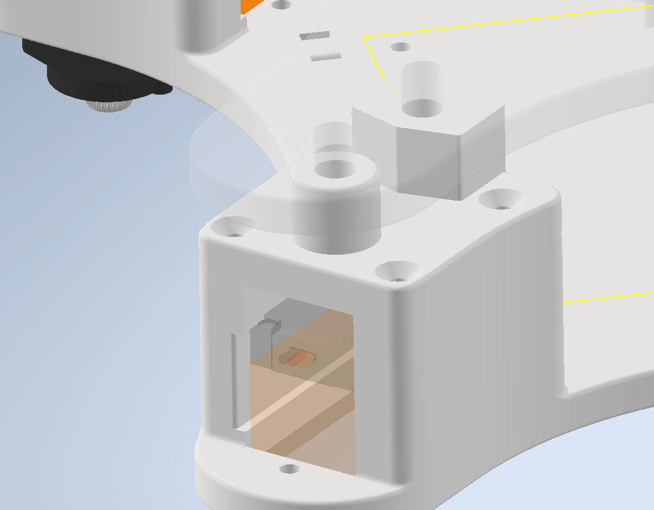
Docs/Presentations/képek/test-kabel.png
