altex111/Quadruped/Docs/Presentations/képek/test-persely.png

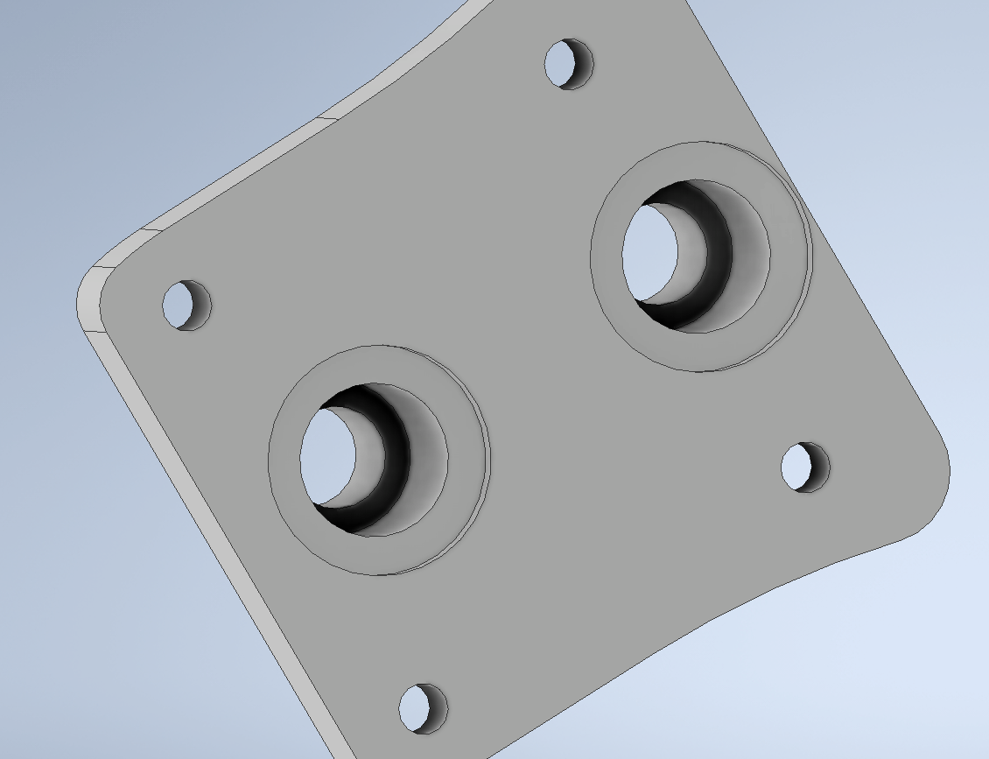
Docs/Presentations/képek/test-persely.png
