altex111/Quadruped/(list of files, drawings)

Other design files:
Hardware/Babits Mátyás/hallglib.SchLib
Hardware/Babits Mátyás/mcu.SchDoc
Hardware/Babits Mátyás/motor.SchDoc
Hardware/Babits Mátyás/pcb.PcbDoc
Hardware/Babits Mátyás/power.SchDoc
Hardware/Babits Mátyás/qlib.PcbLib
Hardware/Babits Mátyás/qlib.SchLib
Hardware/Babits Mátyás/Quadruped.PrjPcb
Hardware/Babits Mátyás/wifi_sensor.SchDoc
Quadruped/Hardware/Babits Mátyás/hallglib.SchLib
Quadruped/Hardware/Babits Mátyás/mcu.SchDoc
Quadruped/Hardware/Babits Mátyás/motor.SchDoc
Quadruped/Hardware/Babits Mátyás/pcb.PcbDoc
Quadruped/Hardware/Babits Mátyás/power.SchDoc
Quadruped/Hardware/Babits Mátyás/qlib.PcbLib
Quadruped/Hardware/Babits Mátyás/qlib.SchLib
Quadruped/Hardware/Babits Mátyás/Quadruped.PrjPcb
Quadruped/Hardware/Babits Mátyás/wifi_sensor.SchDoc
