altex111/Quadruped/Quadruped/Software/Firmware/Quadruped/Src/cmain.c

/**
  ******************************************************************************
  * @file           : main.c
  * @brief          : Main program body
  ******************************************************************************
  ** This notice applies to any and all portions of this file
  * that are not between comment pairs USER CODE BEGIN and
  * USER CODE END. Other portions of this file, whether 
  * inserted by the user or by software development tools
  * are owned by their respective copyright owners.
  *
  * COPYRIGHT(c) 2018 STMicroelectronics
  *
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
  ******************************************************************************
  */
/* Includes ------------------------------------------------------------------*/
#include <cmain.h>
#include "adc.h"
#include "tim.h"
#include "usart.h"
#include "gpio.h"


/* USER CODE BEGIN PV */

/* USER CODE END PV */

static void LL_Init(void);
void SystemClock_Config(void);
static void MX_NVIC_Init(void);

/* USER CODE BEGIN PFP */

/* USER CODE END PFP */

/* USER CODE BEGIN 0 */

void Timer_PostInit()
{
	  LL_TIM_EnableCounter(TIM1);
	  LL_TIM_EnableCounter(TIM2);
	  LL_TIM_EnableCounter(TIM3);
	  LL_TIM_EnableCounter(TIM4);
}

void ADC_PostInit()
{
	const uint32_t LOOP_CYCLE_TIME = 4;
	uint32_t wait_loop_index;

	LL_ADC_DisableDeepPowerDown(ADC1);
	LL_ADC_EnableInternalRegulator(ADC1);
	wait_loop_index = (LL_ADC_DELAY_INTERNAL_REGUL_STAB_US*SystemCoreClock) / (LOOP_CYCLE_TIME*1000000);
	while (wait_loop_index--);

	LL_ADC_StartCalibration(ADC1, LL_ADC_SINGLE_ENDED);
	while (LL_ADC_IsCalibrationOnGoing(ADC1));

	LL_ADC_ClearFlag_ADRDY(ADC1);
	LL_ADC_Enable(ADC1);
	while (!LL_ADC_IsActiveFlag_ADRDY(ADC1));
}

void USART3_IRQCallback(){}
void UART4_IRQCallback(){}
/* USER CODE END 0 */

/**
  * @brief  The application entry point.
  *
  * @retval None
  */
void Init(void)
{
  /* MCU Configuration----------------------------------------------------------*/

  /* Reset of all peripherals, Initializes the Flash interface and the Systick. */
  LL_Init();

  /* Configure the system clock */
  SystemClock_Config();

  /* Initialize all configured peripherals */
  MX_GPIO_Init();
  MX_ADC1_Init();
  MX_TIM1_Init();
  MX_TIM2_Init();
  MX_TIM3_Init();
  MX_TIM4_Init();
  MX_UART4_Init();
  MX_USART3_UART_Init();

  /* Initialize interrupts */
  MX_NVIC_Init();
  /* USER CODE BEGIN 2 */
  Timer_PostInit();
  ADC_PostInit();
  /* USER CODE END 2 */

}
static void LL_Init(void)
{
  

  LL_APB2_GRP1_EnableClock(LL_APB2_GRP1_PERIPH_SYSCFG);
  LL_APB1_GRP1_EnableClock(LL_APB1_GRP1_PERIPH_PWR);

  NVIC_SetPriorityGrouping(NVIC_PRIORITYGROUP_4);

  /* System interrupt init*/
  /* MemoryManagement_IRQn interrupt configuration */
  NVIC_SetPriority(MemoryManagement_IRQn, NVIC_EncodePriority(NVIC_GetPriorityGrouping(),0, 0));
  /* BusFault_IRQn interrupt configuration */
  NVIC_SetPriority(BusFault_IRQn, NVIC_EncodePriority(NVIC_GetPriorityGrouping(),0, 0));
  /* UsageFault_IRQn interrupt configuration */
  NVIC_SetPriority(UsageFault_IRQn, NVIC_EncodePriority(NVIC_GetPriorityGrouping(),0, 0));
  /* SVCall_IRQn interrupt configuration */
  NVIC_SetPriority(SVCall_IRQn, NVIC_EncodePriority(NVIC_GetPriorityGrouping(),0, 0));
  /* DebugMonitor_IRQn interrupt configuration */
  NVIC_SetPriority(DebugMonitor_IRQn, NVIC_EncodePriority(NVIC_GetPriorityGrouping(),0, 0));
  /* PendSV_IRQn interrupt configuration */
  NVIC_SetPriority(PendSV_IRQn, NVIC_EncodePriority(NVIC_GetPriorityGrouping(),0, 0));
  /* SysTick_IRQn interrupt configuration */
  NVIC_SetPriority(SysTick_IRQn, NVIC_EncodePriority(NVIC_GetPriorityGrouping(),0, 0));

}

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
