altex111/Quadruped/Quadruped/Software/Firmware/Quadroped_ros/quadruped.ioc

Mcu.UserName=STM32L476RETx
PA0.Signal=S_TIM2_CH1
PA1.Signal=S_TIM2_CH2
PA10.Signal=S_TIM1_CH3
PA11.Signal=S_TIM1_CH4
PA2.Signal=S_TIM2_CH3
PA3.Signal=S_TIM2_CH4
PA6.Signal=GPIO_Output
PA7.Signal=GPIO_Output
PA8.Signal=S_TIM1_CH1
PA9.Signal=S_TIM1_CH2
PB0.Signal=GPIO_Output
PB1.Signal=GPIO_Output
PB10.Signal=GPIO_Output
PB11.Signal=GPIO_Output
PB12.Signal=GPIO_Output
PB2.Signal=GPIO_Output
PB5.Signal=GPIO_Output
PB6.Signal=GPIO_Output
PB7.Signal=GPIO_Output
PB8.Signal=GPIO_Input
PB9.Signal=GPIO_Input
PC0.Signal=ADCx_IN1
PC1.Signal=ADCx_IN2
PC10.Signal=UART4_TX
PC11.Signal=UART4_RX
PC2.Signal=GPIO_Output
PC3.Signal=GPIO_Output
PC4.Signal=USART3_TX
PC5.Signal=USART3_RX
PC6.Signal=S_TIM3_CH1
PC7.Signal=S_TIM3_CH2
PC8.Signal=S_TIM3_CH3
PC9.Signal=S_TIM3_CH4
