altex111/Quadruped/Quadruped/Software/Converter-main/Converter/Code/scene.cpp

#include "scene.h"
#include <map>

extern std::wstring g_ExeFolder;

namespace cvt
{
	int Scene::ModelTypeToIndex(UINT modelType)
	{
		switch (modelType)
		{
		case gfx::ModelType::P:
			return 0;
		case gfx::ModelType::PT:
			return 1;
		case gfx::ModelType::PN:
			return 2;
		case gfx::ModelType::PTN:
			return 3;
		case gfx::ModelType::PM:
			return 4;
		case gfx::ModelType::PTM:
			return 5;
		}
		return -1;
	}
	Scene::Scene(gfx::Graphics& graphics) :
		m_graphics(graphics),
		m_camController(m_cam),
		m_showHitbox(true)
	{
		m_ps[0] = gfx::PixelShader::U(new gfx::PixelShader(m_graphics, gfx::ModelType::P));
		m_ps[1] = gfx::PixelShader::U(new gfx::PixelShader(m_graphics, gfx::ModelType::PT));
		m_ps[2] = gfx::PixelShader::U(new gfx::PixelShader(m_graphics, gfx::ModelType::PN));
		m_ps[3] = gfx::PixelShader::U(new gfx::PixelShader(m_graphics, gfx::ModelType::PTN));
		m_ps[4] = gfx::PixelShader::U(new gfx::PixelShader(m_graphics, gfx::ModelType::PM));
		m_ps[5] = gfx::PixelShader::U(new gfx::PixelShader(m_graphics, gfx::ModelType::PTM));
		m_vs[0] = gfx::VertexShader::U(new gfx::VertexShader(m_graphics, gfx::ModelType::P));
		m_vs[1] = gfx::VertexShader::U(new gfx::VertexShader(m_graphics, gfx::ModelType::PT));
		m_vs[2] = gfx::VertexShader::U(new gfx::VertexShader(m_graphics, gfx::ModelType::PN));
		m_vs[3] = gfx::VertexShader::U(new gfx::VertexShader(m_graphics, gfx::ModelType::PTN));
		m_vs[4] = gfx::VertexShader::U(new gfx::VertexShader(m_graphics, gfx::ModelType::PM));
		m_vs[5] = gfx::VertexShader::U(new gfx::VertexShader(m_graphics, gfx::ModelType::PTM));
		m_matrixBuffer = gfx::CBuffer::U(new gfx::CBuffer(m_graphics, sizeof(mth::matrix) * 2));
		m_lightBuffer = gfx::CBuffer::U(new gfx::CBuffer(m_graphics, sizeof(float) * 8));
		m_colorBuffer = gfx::CBuffer::U(new gfx::CBuffer(m_graphics, sizeof(float) * 4));
		m_sampler = gfx::SamplerState::U(new gfx::SamplerState(m_graphics));

		unsigned char img[16 * 16 * 4];
		for (int x = 0; x < 16; x++)
			for (int y = 0; y < 16; y++)
			{
				unsigned char c = ((x & 8) ^ (y & 8)) ? 0 : 255;
				img[(x + y * 16) * 4 + 0] = c;
				img[(x + y * 16) * 4 + 1] = 0;
				img[(x + y * 16) * 4 + 2] = c;
				img[(x + y * 16) * 4 + 3] = 255;
			}
		m_defaultTexture = std::make_shared<gfx::Texture>(m_graphics, img, 16, 16);
		for (int x = 0; x < 16; x++)
			for (int y = 0; y < 16; y++)
			{
				img[(x + y * 16) * 4 + 0] = 127;
				img[(x + y * 16) * 4 + 1] = 127;
				img[(x + y * 16) * 4 + 2] = 255;
				img[(x + y * 16) * 4 + 3] = 255;
			}
		m_defaultNormalmap = std::make_shared<gfx::Texture>(m_graphics, img, 16, 16);

		m_cam.SetScreenAspect(1000.0f / 720.0f);
		m_camController.SetTargetPosition();

		gfx::VertexShader::SetCBuffer(m_graphics, *m_matrixBuffer);
		gfx::PixelShader::SetCBuffer(m_graphics, *m_lightBuffer, 0);
		gfx::PixelShader::SetCBuffer(m_graphics, *m_colorBuffer, 1);
		m_sampler->SetSamplerState(m_graphics);
	}

	void Scene::SetEntityDefaultCube(gfx::ModelLoader& ml)
	{
		ml.CreateCube(-1.0f, 2.0f, gfx::ModelType::PTN);
		gfx::Model::P model = std::make_shared<gfx::Model>(m_graphics, ml);
		int shaderIndex = ModelTypeToIndex(ml.getModelType());
		gfx::VertexShader::P vs = m_vs[shaderIndex];
		gfx::PixelShader::P ps = m_ps[shaderIndex];
		vs->SetShaderToRender(m_graphics);
		ps->SetShaderToRender(m_graphics);
		gfx::Material::P material;

		int textureWidth = 512;
		int textureHeight = 512;
		std::vector<unsigned char> img(textureWidth * textureHeight * 4);
		for (int x = 0; x < textureWidth; x++)
			for (int y = 0; y < textureHeight; y++)
			{
				float i;
				float cx = ((float)x - float(textureWidth) * 0.7f) / float(textureWidth) * 2.5f;
				float cy = ((float)y - float(textureHeight) * 0.5f) / float(textureHeight) * 2.5f;
				float tx, ty, zx = 0.0f, zy = 0.0f;

				for (i = 0.0f; i < 256.0f; i++)
				{
					tx = zx * zx - zy * zy;
					ty = 2.0f * zx * zy;
					zx = tx + cx;
					zy = ty + cy;
					if (zx * zx + zy * zy > 4.0f)
						break;
				}

				i /= 256.0f;
				float r = fabsf(6.0f * i - 3.0f) - 1.0f;
				float g = 2.0f - fabsf(6.0f * i - 2.0f);
				float b = 2.0f - fabsf(6.0f * i - 4.0f);
				r *= (1.0f - r * 0.49f);
				g *= (1.0f - r * 0.49f);
				b *= (1.0f - r * 0.49f);
				if (r < 0.0f)r = 0.0f;
				else if (r > 1.0f)r = 1.0f;
				if (g < 0.0f)g = 0.0f;
				else if (g > 1.0f)g = 1.0f;
				if (b < 0.0f)b = 0.0f;
				else if (b > 1.0f)b = 1.0f;

				img[(x + y * textureWidth) * 4 + 0] = (char)(r * 255.0f);
				img[(x + y * textureWidth) * 4 + 1] = (char)(g * 255.0f);
				img[(x + y * textureWidth) * 4 + 2] = (char)(b * 255.0f);
				img[(x + y * textureWidth) * 4 + 3] = 255;
			}

		material = std::make_shared<gfx::Material>(vs, ps, std::make_shared<gfx::Texture>(m_graphics, img.data(), textureWidth, textureHeight), nullptr);

		m_entity = gfx::Entity::U(new gfx::Entity(model, &material));
	}

	void Scene::SetEntity(gfx::ModelLoader& ml)
	{
		gfx::Model::P model = std::make_shared<gfx::Model>(m_graphics, ml);
		std::vector<gfx::Material::P> allMaterials, usedMaterials;
		int shaderIndex = ModelTypeToIndex(ml.getModelType());
		gfx::VertexShader::P vs = m_vs[shaderIndex];
		gfx::PixelShader::P ps = m_ps[shaderIndex];
		vs->SetShaderToRender(m_graphics);
		ps->SetShaderToRender(m_graphics);
		allMaterials.resize(ml.getMaterialCount());
		std::map<std::wstring, gfx::Texture::P> textures;
		for (UINT i = 0; i < ml.getMaterialCount(); i++)
		{
			gfx::Texture::P tex, norm;
			auto& t = ml.getTexture(i);
			auto& n = ml.getNormalmap(i);
			if (t.loaded)
			{
				tex = std::make_shared<gfx::Texture>(m_graphics, t.data.data(), t.width, t.height);
			}
			else
			{
				if (t.filename[0])
				{
					if (textures.find(t.filename) == textures.end())
					{
						try
						{
							tex = std::make_shared<gfx::Texture>(m_graphics, (ml.getFolderName() + t.filename).c_str());
						}
						catch (std::exception e)
						{
							MessageBox(m_graphics.getHWND(), ToWStr(e.what()).c_str(), L"Error", MB_OK);
							tex = m_defaultTexture;
						}
						textures[t.filename] = tex;
					}
					else
					{
						tex = textures[t.filename];
					}
				}
				else
					tex = m_defaultTexture;
			}
			if (n.loaded)
			{
				norm = std::make_shared<gfx::Texture>(m_graphics, n.data.data(), n.width, n.height);
			}
			else
			{
				if (n.filename[0])
				{
					if (textures.find(n.filename) == textures.end())
					{
						try
						{
							norm = std::make_shared<gfx::Texture>(m_graphics, (ml.getFolderName() + n.filename).c_str());
						}
						catch (std::exception e)
						{
							MessageBox(m_graphics.getHWND(), ToWStr(e.what()).c_str(), L"Error", MB_OK);
							norm = m_defaultNormalmap;
						}
						textures[n.filename] = norm;
					}
					else
					{
						norm = textures[n.filename];
					}
				}
				else
					norm = m_defaultNormalmap;
			}
			allMaterials[i] = std::make_shared<gfx::Material>(vs, ps, tex, norm);
		}

		usedMaterials.resize(ml.getVertexGroupCount());
		for (UINT i = 0; i < ml.getVertexGroupCount(); i++)
			usedMaterials[i] = allMaterials[ml.getVertexGroup(i).materialIndex];

		m_entity = gfx::Entity::U(new gfx::Entity(model, usedMaterials.data()));
	}
	void Scene::ClearEntity()
	{
		m_entity.reset();
	}

	void Scene::SetHitbox(gfx::ModelLoader& ml)
	{
		gfx::Model::P model = std::make_shared<gfx::Model>(m_graphics, ml);
		std::vector<gfx::Material::P> allMaterials, usedMaterials;
		int shaderIndex = ModelTypeToIndex(ml.getModelType());
		gfx::VertexShader::P vs = m_vs[shaderIndex];
		gfx::PixelShader::P ps = m_ps[shaderIndex];
		vs->SetShaderToRender(m_graphics);
		ps->SetShaderToRender(m_graphics);
		allMaterials.resize(ml.getMaterialCount());
		for (UINT i = 0; i < ml.getMaterialCount(); i++)
			allMaterials[i] = std::make_shared<gfx::Material>(vs, ps,
				ml.getTexture(i).filename[0] ? std::make_shared<gfx::Texture>(m_graphics, (ml.getFolderName() + ml.getTexture(i).filename).c_str()) : nullptr,
				ml.getNormalmap(i).filename[0] ? std::make_shared<gfx::Texture>(m_graphics, (ml.getFolderName() + ml.getNormalmap(i).filename).c_str()) : nullptr);

		usedMaterials.resize(ml.getVertexGroupCount());
		for (UINT i = 0; i < ml.getVertexGroupCount(); i++)
			usedMaterials[i] = allMaterials[ml.getVertexGroup(i).materialIndex];

		m_hitbox = gfx::Entity::U(new gfx::Entity(model, usedMaterials.data()));
	}
	void Scene::ClearHitbox()
	{
		m_hitbox.reset();
	}

	bool Scene::HandleCamera(UINT msg, WPARAM wparam, LPARAM lparam)
	{
		return m_camController.MessageHandler(msg, wparam, lparam);
	}

	void Scene::Render()
	{
		m_graphics.ClearScreen(0.1f, 0.1f, 0.2f);
		m_cam.Update();
		mth::matrix matrices[2];
		matrices[1] = m_cam.GetCameraMatrix();
		float lightBuffer[] = {
			1.0f, 1.0f, 1.0f, 1.0f,
			m_cam.position.x, m_cam.position.y, m_cam.position.z,
			0.5f
		};
		m_lightBuffer->WriteBuffer(m_graphics, lightBuffer);

		if (m_entity)
		{
			matrices[0] = m_entity->GetWorldMatrix();
			m_matrixBuffer->WriteBuffer(m_graphics, matrices);
			mth::float4 colorBuffer = m_entity->getColor();
			m_colorBuffer->WriteBuffer(m_graphics, &colorBuffer);

			m_graphics.RasterizerSolid();
			m_entity->Render(m_graphics);
		}

		if (m_showHitbox && m_hitbox)
		{
			matrices[0] = m_hitbox->GetWorldMatrix();
			m_matrixBuffer->WriteBuffer(m_graphics, matrices);
			mth::float4 colorBuffer = m_hitbox->getColor();
			m_colorBuffer->WriteBuffer(m_graphics, &colorBuffer);

			m_graphics.RasterizerWireframe();
			m_hitbox->Render(m_graphics);
		}

		m_graphics.Present();
	}
}
