altex111/Quadruped/Software/Simulator/Simulator/quad_walkscript.cpp

#include "quad_walkscript.h"

namespace quad
{
#pragma region WalkScript

	void WalkScript::AddPathElementLegMovement(LegID legid, mth::float2 pos)
	{
		QuadAction qa;
		qa.legID = legid;
		qa.goalPos = pos;
		m_script.push_back(qa);
	}
	void WalkScript::AddPathElementBodyMovement(mth::float2 pos, float turn)
	{
		QuadAction qa;
		qa.legID = -1;
		qa.goalPos = pos;
		qa.rot = turn;
		m_script.push_back(qa);
	}

	void WalkScript::AddLegTurnRightBalanced(mth::float2x2 rotmat)
	{
		AddPathElementLegMovement(LID_LB, rotmat * mth::float2(-m_legXPos, -(m_legZRetracted + m_maxLegStretchHalf)));
		AddPathElementLegMovement(LID_LF, rotmat * mth::float2(-m_legXPos, m_legZRetracted + m_maxLegStretchHalf));
		AddPathElementLegMovement(LID_RF, rotmat * mth::float2(m_legXPos, m_legZRetracted + m_maxLegStretchHalf));
		AddPathElementLegMovement(LID_RB, rotmat * mth::float2(m_legXPos, -(m_legZRetracted + m_maxLegStretchHalf)));
	}
	void WalkScript::AddLegTurnLeftBalanced(mth::float2x2 rotmat)
	{
		AddPathElementLegMovement(LID_RB, rotmat * mth::float2(m_legXPos, -(m_legZRetracted + m_maxLegStretchHalf)));
		AddPathElementLegMovement(LID_RF, rotmat * mth::float2(m_legXPos, m_legZRetracted + m_maxLegStretchHalf));
		AddPathElementLegMovement(LID_LF, rotmat * mth::float2(-m_legXPos, m_legZRetracted + m_maxLegStretchHalf));
		AddPathElementLegMovement(LID_LB, rotmat * mth::float2(-m_legXPos, -(m_legZRetracted + m_maxLegStretchHalf)));
	}
	void WalkScript::AddLegBodyElementsTurn(float angle)
	{
		float ratio = min(fabsf(angle) / m_maxTurnAtOnce, 1.0f);
		if (angle < 0.0f)
			ratio = -ratio;
		mth::float2x2 rotmat = mth::float2x2::Rotation(-ratio * m_maxTurnAtOnce);
		if (m_rightBalanced)
			AddLegTurnRightBalanced(rotmat);
		else
			AddLegTurnLeftBalanced(rotmat);
		m_rightBalanced = angle > 0.0f;
		AddPathElementBodyMovement(mth::float2(), m_maxTurnAtOnce * ratio);
	}

	void WalkScript::AddLegWalkRightBalanced(float ratio)
	{
		AddPathElementLegMovement(LID_LB, mth::float2(-m_legXPos, -m_legZRetracted - (1.0f - ratio)*m_maxLegStretchHalf));
		AddPathElementLegMovement(LID_LF, mth::float2(-m_legXPos, m_legZRetracted + 2.0f*m_maxLegStretchHalf - (1.0f - ratio)*m_maxLegStretchHalf));
		m_rightBalanced = false;
	}
	void WalkScript::AddLegWalkRightBalanced(mth::float2 ratio)
	{
		AddPathElementLegMovement(LID_LB, mth::float2(-m_legXPos + ratio[0] , -m_legXPos + ratio[1]));
		AddPathElementLegMovement(LID_LF, mth::float2(-m_legXPos + ratio[0], m_legXPos + ratio[1]));
		m_rightBalanced = false;
	}
	void WalkScript::AddLegWalkLeftBalanced(float ratio)
	{
		AddPathElementLegMovement(LID_RB, mth::float2(m_legXPos, -m_legZRetracted - (1.0f - ratio)*m_maxLegStretchHalf));
		AddPathElementLegMovement(LID_RF, mth::float2(m_legXPos, m_legZRetracted + 2.0f*m_maxLegStretchHalf - (1.0f - ratio)*m_maxLegStretchHalf));
		m_rightBalanced = true;
	}
	void WalkScript::AddLegWalkLeftBalanced(mth::float2 ratio)
	{
		AddPathElementLegMovement(LID_RB, mth::float2(m_legXPos + ratio[0], -m_legXPos + ratio[1]));
		AddPathElementLegMovement(LID_RF, mth::float2(m_legXPos + ratio[0], m_legXPos + ratio[1]));
		m_rightBalanced = true;
	}
	void WalkScript::AddLegBodyElementsWalkStraight(float distance)
	{
		float ratio = min(distance / m_maxLegStretchHalf, 1.0f);
		if (m_rightBalanced)
			AddLegWalkRightBalanced(ratio);
		else
			AddLegWalkLeftBalanced(ratio);
		AddPathElementBodyMovement(mth::float2(0.0f, m_maxLegStretchHalf*ratio), 0.0f);
	}

	/*void WalkScript::AddLegBodyElementsMove(float distance, float walkAngle, float turnAngle)
	{
		float deltaDistanceX = m_legStretchHalf * sinf(walkAngle);
		float deltaDistanceY = m_legStretchHalf * cosf(walkAngle);
		//float deltaTurnAngle =
		mth::float2 ratio(deltaDistanceX, deltaDistanceY);
		if (m_rightBalanced)
			AddLegWalkRightBalanced(ratio);
		else
			AddLegWalkLeftBalanced(ratio);
		AddPathElementBodyMovement(mth::float2(m_legStretchHalf * ratio[0], m_legStretchHalf * ratio[1]), 0.0f);
	}*/

	WalkScript::WalkScript() :
		m_maxTurnAtOnce(mth::pi * 0.25f),
		m_bellyy(0.3f),
		m_legLift(0.2f),
		m_legXPos(0.9f),
		m_legZRetracted(0.4f),
		m_maxLegStretchHalf(0.5f),
		m_rightBalanced(true) {}

	void WalkScript::AddPathElementTurn(float angle)
	{
		float angleabs = fabsf(angle);
		while (angleabs > 0.0f)
		{
			AddLegBodyElementsTurn(angle);
			angleabs -= m_maxTurnAtOnce;
			if (angle > 0.0f)
				angle -= m_maxTurnAtOnce;
			else
				angle += m_maxTurnAtOnce;
		}
	}

	void WalkScript::AddPathElementWalkStraight(float distance)
	{
		while (distance > 0.0f)
		{
			AddLegBodyElementsWalkStraight(distance);
			distance -= m_maxLegStretchHalf;
		}
	}

	void WalkScript::AddPathElementMove(float distance, float walkAngle, float turnAngle)
	{
		float legStretchHalf = 0;
		float turnAtOnce = 0;
		float preferedSteps = ceilf(distance / m_maxLegStretchHalf); // calculate minimum steps
		float preferedTurnAtOnce = fabsf(turnAngle) / preferedSteps; // calculate prefered one turn angle
		float turnAngleAbs = fabsf(turnAngle);
		if (preferedTurnAtOnce > m_maxTurnAtOnce)
		{
			//calculate parameters when preferdTurnAtOnce biger then the robot can handle
			float steps = ceilf(fabsf(turnAngle) / m_maxTurnAtOnce); // calculate new step number
			legStretchHalf = distance / steps;	// calculate new step distance
			turnAtOnce = fabsf(turnAngle) / steps; // calculate new turn angle per step
		}
		else
		{
			legStretchHalf = distance / preferedSteps;
			turnAtOnce = preferedTurnAtOnce;
		}
		while (distance > 0.0f || turnAngleAbs > 0.0f)
		{
			//AddLegBodyElementsMove(legStretchHalf, walkAngle, turnAtOnce);
			if(distance > 0.0f)
				distance -= legStretchHalf;
			if (turnAngleAbs)
			{
				turnAngleAbs -= turnAtOnce;
				if (turnAngle > 0.0f)
					turnAngle -= turnAtOnce;
				else
					turnAngle += turnAtOnce;
			}
			
		}
	}

	void WalkScript::AddPathElementCycloidMove(float pos)
	{
		AddPathElementBodyMovement(mth::float2(pos, pos), 0.0f);
		AddPathElementBodyMovement(mth::float2(pos, -pos), 0.0f); 
		AddPathElementBodyMovement(mth::float2(-pos, -pos), 0.0f);
		AddPathElementBodyMovement(mth::float2(-pos, pos), 0.0f);
	}

	void WalkScript::AddPathElementCircle(float circleR, float rotation)
	{
		float rotabs = fabsf(rotation);
		float rotpermove = m_maxLegStretchHalf / circleR;
		mth::float2x2 rotmat = mth::float2x2::Rotation(rotpermove);
		QuadAction qa;
		while (rotabs > 0.0f)
		{
			if (m_rightBalanced)
			{				
				m_rightBalanced = false;
			}
			else
			{
				m_rightBalanced = true;
			}
			qa.goalPos = rotmat * mth::float2(0.0f, m_maxLegStretchHalf);

			rotabs -= rotpermove;
			if (rotation > 0.0f)
				rotation -= rotpermove;
			else
				rotation += rotpermove;
		}
	}

	float DegreeToAngle(int degree)
	{
		return (((float)degree) / 180) * mth::pi;
	}

	void WalkScript::Clear()
	{
		m_script.clear();
	}

	bool WalkScript::NextAction(QuadAction& action)
	{
		if (m_script.empty())
			return false;
		action = *m_script.begin();
		m_script.pop_front();
		return true;
	}
	mth::float3 WalkScript::getLegRFStartPos()
	{
		return { m_legXPos, -m_bellyy, m_legZRetracted/* + m_maxLegStretchHalf*/ };
		//return { 0.35f + 0.461f + 0.4f*sinf(mth::pi / 6.0f), -m_bellyy, 0.4f + 0.5268f + 0.4f*cosf(mth::pi / 6.0f) };
	}
	mth::float3 WalkScript::getLegLFStartPos()
	{
		return { -m_legXPos, -m_bellyy, m_legZRetracted/* + m_maxLegStretchHalf*/ };
		//return { -(0.9f + 0.3f * sinf(mth::pi / 4.0f)), -m_bellyy, 0.9f + 0.3f * cosf(mth::pi / 4.0f) };
	}
	mth::float3 WalkScript::getLegRBStartPos()
	{
		return { m_legXPos, -m_bellyy, -(m_legZRetracted/* + m_maxLegStretchHalf*/) };
	}
	mth::float3 WalkScript::getLegLBStartPos()
	{
		return { -m_legXPos, -m_bellyy, -(m_legZRetracted/* + m_maxLegStretchHalf*/) };
	}
	float WalkScript::getBellyY()
	{
		return m_bellyy;
	}
	float WalkScript::LegY(float t)
	{
		t = 2.0f*t - 1.0f;
		return -m_bellyy + (1.0f - t * t)*m_legLift;
	}

#pragma endregion

#pragma region WalkManager

	void WalkManager::Init(Quadruped *quadruped)
	{
		m_script.Clear();
		m_quad = quadruped;
		m_time = 0.0f;
		m_speed = 3.5f;
		m_running = false;
		m_quad->getEntity().position = { 0.0f, m_script.getBellyY(), 0.0f };
		m_quad->getEntity().rotation = { mth::pi * 0.0f, mth::pi * 0.0f, mth::pi * 0.0f };
		m_quad->getLegRF().setPosition(m_script.getLegRFStartPos());
		m_quad->getLegRB().setPosition(m_script.getLegRBStartPos());
		m_quad->getLegLF().setPosition(m_script.getLegLFStartPos());
		m_quad->getLegLB().setPosition(m_script.getLegLBStartPos());
	}

	void WalkManager::MoveBody(float deltaTime)
	{
		mth::float3 delta = { -deltaTime * m_action.goalPos.x, 0.0f, deltaTime * m_action.goalPos.y };
		m_quad->getEntity().MoveInLookDirection(delta);
		m_quad->getEntity().rotation.y += deltaTime * m_action.rot;
		delta = mth::float3x3::RotationY(m_action.rot)*delta;
		for (Leg& l : m_quad->getLegs())
			l.setPosition(mth::float3x3::RotationY(-deltaTime * m_action.rot)*(-delta + l.getPosition()));
	}
	void WalkManager::MoveLeg()
	{
		mth::float3 pos = { m_prevAction.goalPos.x + (m_action.goalPos.x - m_prevAction.goalPos.x)*m_time,
			0.0f, m_prevAction.goalPos.y + (m_action.goalPos.y - m_prevAction.goalPos.y)*m_time };
		pos.Normalize();
		pos *= (1.0f - m_time)*m_prevAction.goalPos.Length() + m_time * m_action.goalPos.Length();
		pos.y = m_script.LegY(m_time);
		m_quad->getLeg(m_action.legID).setPosition(pos);
	}
	void WalkManager::ReceiveNextAction()
	{
		if (m_running = m_script.NextAction(m_action))
		{
			if (m_action.legID >= 0)
			{
				mth::float3 prevPos = m_quad->getLeg(m_action.legID).getPosition();
				m_prevAction.goalPos.x = prevPos.x;
				m_prevAction.goalPos.y = prevPos.z;
			}
		}
	}
	float WalkManager::FinishPreviousAction(float timeLeft)
	{
		if (m_action.legID < 0)
			MoveBody(timeLeft);
		else
			m_quad->getLeg(m_action.legID).setPosition({ m_action.goalPos.x, -m_script.getBellyY(), m_action.goalPos.y });
		ReceiveNextAction();
		m_time = fmodf(m_time, 1.0f);
		return m_time;
	}
	void WalkManager::ExecuteAction(float deltaTime)
	{
		m_time += deltaTime;
		if (m_time >= 1.0f)
			deltaTime = FinishPreviousAction(1.0f - (m_time - deltaTime));
		if (m_action.legID < 0)
			MoveBody(deltaTime);
		else
			MoveLeg();
	}
	void WalkManager::Update(float deltaTime)
	{
		if (!m_running)
		{
			//m_script.AddPathElementWalkStraight(2.1f);
			//m_script.AddPathElementMove(2.0f, mth::pi / 6.0f, 0.0f);
			//m_script.AddPathElementTurn(-mth::pi*0.5f);
			//m_script.AddPathElementCycloidMove(0.2f);
			ReceiveNextAction();
			m_time = 0.0f;
		}
		if (m_running)
			ExecuteAction(deltaTime * m_speed);
	}
	WalkScript& WalkManager::getWalkScript()
	{
		return m_script;
	}

#pragma endregion
}
