altex111/Quadruped/Software/Simulator/Simulator/graphics.cpp

#include "graphics.h"

#pragma comment(lib, "d3d11.lib")
#pragma comment(lib, "d3dcompiler.lib")

namespace gfx
{
	bool Graphics::Init(HWND hwnd)
	{
		RECT rect;
		DXGI_SWAP_CHAIN_DESC swapChainDesc{};
		D3D_FEATURE_LEVEL featureLevel[] = {
			D3D_FEATURE_LEVEL_11_1,
			D3D_FEATURE_LEVEL_11_0
		};
		GetClientRect(hwnd, &rect);
		swapChainDesc.BufferCount = 2;
		swapChainDesc.BufferDesc.Width = rect.right - rect.left;
		swapChainDesc.BufferDesc.Height = rect.bottom - rect.top;
		swapChainDesc.BufferDesc.Format = DXGI_FORMAT_R8G8B8A8_UNORM;
		swapChainDesc.BufferDesc.RefreshRate.Numerator = 0;
		swapChainDesc.BufferDesc.RefreshRate.Denominator = 1;
		swapChainDesc.BufferDesc.ScanlineOrdering = DXGI_MODE_SCANLINE_ORDER_UNSPECIFIED;
		swapChainDesc.BufferDesc.Scaling = DXGI_MODE_SCALING_UNSPECIFIED;
		swapChainDesc.BufferUsage = DXGI_USAGE_RENDER_TARGET_OUTPUT;
		swapChainDesc.OutputWindow = hwnd;
		swapChainDesc.SampleDesc.Count = 1;
		swapChainDesc.SampleDesc.Quality = 0;
		swapChainDesc.Windowed = TRUE;
		swapChainDesc.SwapEffect = DXGI_SWAP_EFFECT_DISCARD;
		swapChainDesc.Flags = 0;
		if (FAILED(D3D11CreateDeviceAndSwapChain(NULL, D3D_DRIVER_TYPE_HARDWARE, NULL, 0,
			featureLevel, sizeof(featureLevel) / sizeof(featureLevel[0]), D3D11_SDK_VERSION,
			&swapChainDesc, &m_swapChain, &m_device, NULL, &m_context)))
			return false;
		AutoReleasePtr<ID3D11Texture2D> backBufferPtr;
		if (FAILED(m_swapChain->GetBuffer(0, __uuidof(ID3D11Texture2D), (void**)&backBufferPtr)))
			return false;
		if (FAILED(m_device->CreateRenderTargetView(backBufferPtr, NULL, &m_renderTargetView)))
			return false;
		D3D11_DEPTH_STENCIL_DESC depthStencilDesc{};
		depthStencilDesc.DepthEnable = TRUE;
		depthStencilDesc.DepthWriteMask = D3D11_DEPTH_WRITE_MASK_ALL;
		depthStencilDesc.DepthFunc = D3D11_COMPARISON_LESS_EQUAL;
		depthStencilDesc.StencilEnable = TRUE;
		depthStencilDesc.StencilReadMask = 0xFF;
		depthStencilDesc.StencilWriteMask = 0xFF;
		depthStencilDesc.FrontFace.StencilFailOp = D3D11_STENCIL_OP_KEEP;
		depthStencilDesc.FrontFace.StencilDepthFailOp = D3D11_STENCIL_OP_INCR;
		depthStencilDesc.FrontFace.StencilPassOp = D3D11_STENCIL_OP_KEEP;
		depthStencilDesc.FrontFace.StencilFunc = D3D11_COMPARISON_ALWAYS;
		depthStencilDesc.BackFace.StencilFailOp = D3D11_STENCIL_OP_KEEP;
		depthStencilDesc.BackFace.StencilDepthFailOp = D3D11_STENCIL_OP_DECR;
		depthStencilDesc.BackFace.StencilPassOp = D3D11_STENCIL_OP_KEEP;
		depthStencilDesc.BackFace.StencilFunc = D3D11_COMPARISON_ALWAYS;
		if (FAILED(m_device->CreateDepthStencilState(&depthStencilDesc, &m_depthStencilState)))
			return false;
		D3D11_TEXTURE2D_DESC depthBufferDesc{};
		depthBufferDesc.Width = rect.right - rect.left;
		depthBufferDesc.Height = rect.bottom - rect.top;
		depthBufferDesc.MipLevels = 1;
		depthBufferDesc.ArraySize = 1;
		depthBufferDesc.Format = DXGI_FORMAT_D24_UNORM_S8_UINT;
		depthBufferDesc.SampleDesc.Count = 1;
		depthBufferDesc.SampleDesc.Quality = 0;
		depthBufferDesc.Usage = D3D11_USAGE_DEFAULT;
		depthBufferDesc.BindFlags = D3D11_BIND_DEPTH_STENCIL;
		depthBufferDesc.CPUAccessFlags = 0;
		depthBufferDesc.MiscFlags = 0;
		if (FAILED(m_device->CreateTexture2D(&depthBufferDesc, NULL, &m_depthStencilBuffer)))
			return false;
		D3D11_DEPTH_STENCIL_VIEW_DESC depthStencilViewDesc{};
		depthStencilViewDesc.Format = DXGI_FORMAT_D24_UNORM_S8_UINT;
		depthStencilViewDesc.ViewDimension = D3D11_DSV_DIMENSION_TEXTURE2D;
		depthStencilViewDesc.Texture2D.MipSlice = 0;
		if (FAILED(m_device->CreateDepthStencilView(m_depthStencilBuffer, &depthStencilViewDesc, &m_depthStencilView)))
			return false;
		D3D11_RASTERIZER_DESC rasterizerDesc{};
		rasterizerDesc.AntialiasedLineEnable = FALSE;
		rasterizerDesc.CullMode = D3D11_CULL_BACK;
		rasterizerDesc.DepthBias = 0;
		rasterizerDesc.DepthBiasClamp = 0.0f;
		rasterizerDesc.DepthClipEnable = TRUE;
		rasterizerDesc.FillMode = D3D11_FILL_SOLID;
		rasterizerDesc.FrontCounterClockwise = FALSE;
		rasterizerDesc.MultisampleEnable = FALSE;
		rasterizerDesc.ScissorEnable = FALSE;
		rasterizerDesc.SlopeScaledDepthBias = 0.0f;
		if (FAILED(m_device->CreateRasterizerState(&rasterizerDesc, &m_rasterizerState)))
			return false;

		D3D11_VIEWPORT viewport;
		viewport.TopLeftX = 0;
		viewport.TopLeftY = 0;
		viewport.Width = (float)(rect.right - rect.left);
		viewport.Height = (float)(rect.bottom - rect.top);
		viewport.MinDepth = 0.0f;
		viewport.MaxDepth = 1.0f;
		m_context->RSSetViewports(1, &viewport);
		m_context->RSSetState(m_rasterizerState);
		m_context->IASetPrimitiveTopology(D3D11_PRIMITIVE_TOPOLOGY_TRIANGLELIST);
		m_context->OMSetRenderTargets(1, &m_renderTargetView, m_depthStencilView);
		m_context->OMSetDepthStencilState(m_depthStencilState, 0);
		return true;
	}
	void Graphics::Shutdown()
	{
		m_device.Release();
		m_context.Release();
		m_swapChain.Release();
		m_renderTargetView.Release();
		m_depthStencilBuffer.Release();
		m_depthStencilView.Release();
		m_depthStencilState.Release();
		m_rasterizerState.Release();
	}
	void Graphics::BeginFrame()
	{
		BeginFrame(0.0f, 0.0f, 0.0f);
	}
	void Graphics::BeginFrame(float r, float g, float b)
	{
		float clearColor[] = { r, g, b, 1.0f };
		m_context->ClearRenderTargetView(m_renderTargetView, clearColor);
		m_context->ClearDepthStencilView(m_depthStencilView, D3D11_CLEAR_DEPTH, 1.0f, 0);
	}
	void Graphics::EndFrame()
	{
		m_swapChain->Present(1, 0);
	}
}
