altex111/Quadruped/(commit log)

2022-03-31 Create file struct
    [BaseBottom_v1.stl, BaseTop_v1.stl, LegEnd_Right_v2.stl, LegEnd_Right_v2_MIR.stl, LegMiddle_Final_1.stl, LegPin_Middle_v1.stl, LegPin_Side_v1.stl, LegPin_Side_v1_MIR.stl]
2022-03-31 Modell upload
    [BaseBottom_v1.0039.ipt, BaseBottom_v1.ipt, BaseBottom_v1.stl, BaseTop_v1.0024.ipt, BaseTop_v1.ipt, BaseTop_v1.stl, Body.iam, Body.stl]
2022-04-02 offset implementation
    [LegEnd_MIR.stl, camera.obj, entity.obj, graphics.obj, linalg.obj, main.obj, model.obj, position.obj]
2022-04-03 stl update
    [BaseBottom_v1.0040.ipt, BaseBottom_v1.ipt, Body.0001.iam, Body.iam, LegEnd.0001.iam, LegEnd.iam, LegEnd.stl, LegEnd_MIR.0001.iam]
2022-04-03 stl debug
    [LegStart.stl, LegStart_MIR.stl]
2022-04-07 redesign files
    [BaseBottom_v1.0039.ipt, BaseBottom_v1.0040.ipt, BaseBottom_v1.ipt, BaseBottom_v1.stl, BaseTop_v1.0024.ipt, BaseTop_v1.ipt, BaseTop_v1.stl, Body.0001.iam]
