altex111/Quadruped/(notices)

Notices in the files:
Quadruped/Software/Firmware/Quadruped/Src/cmain.c:
(C) COPYRIGHT STMicroelectronics *****END OF FILE
